Machao615/Dummy-Mar/5.Misc/PCB/controller_bot.jpg

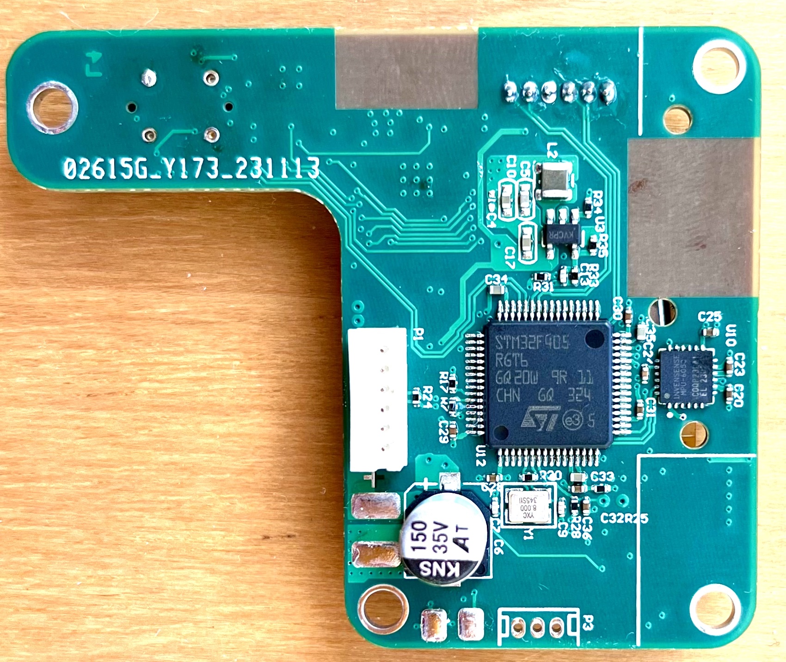
5.Misc/PCB/controller_bot.jpg
