Machao615/Dummy-Mar/5.Misc/PCB/top.jpg

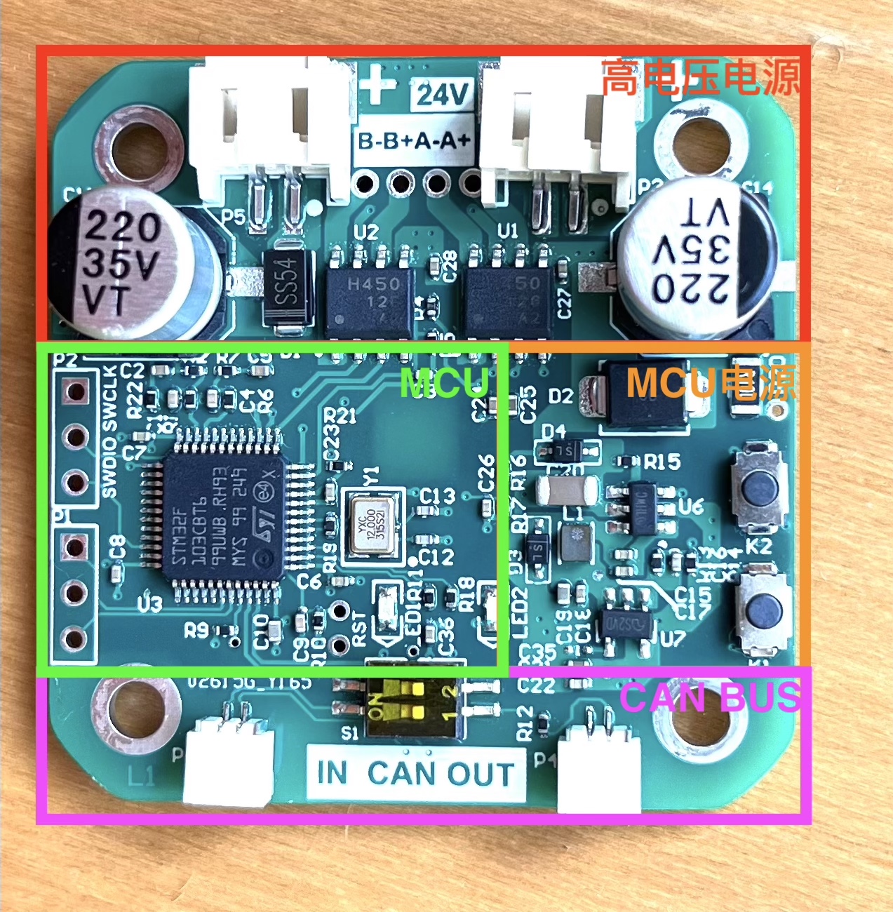
5.Misc/PCB/top.jpg
