Machao615/Dummy-Mar/3.Firmware/esp32-iot/firmware/examples/device-dashboard/screenshots/dashboard.webp

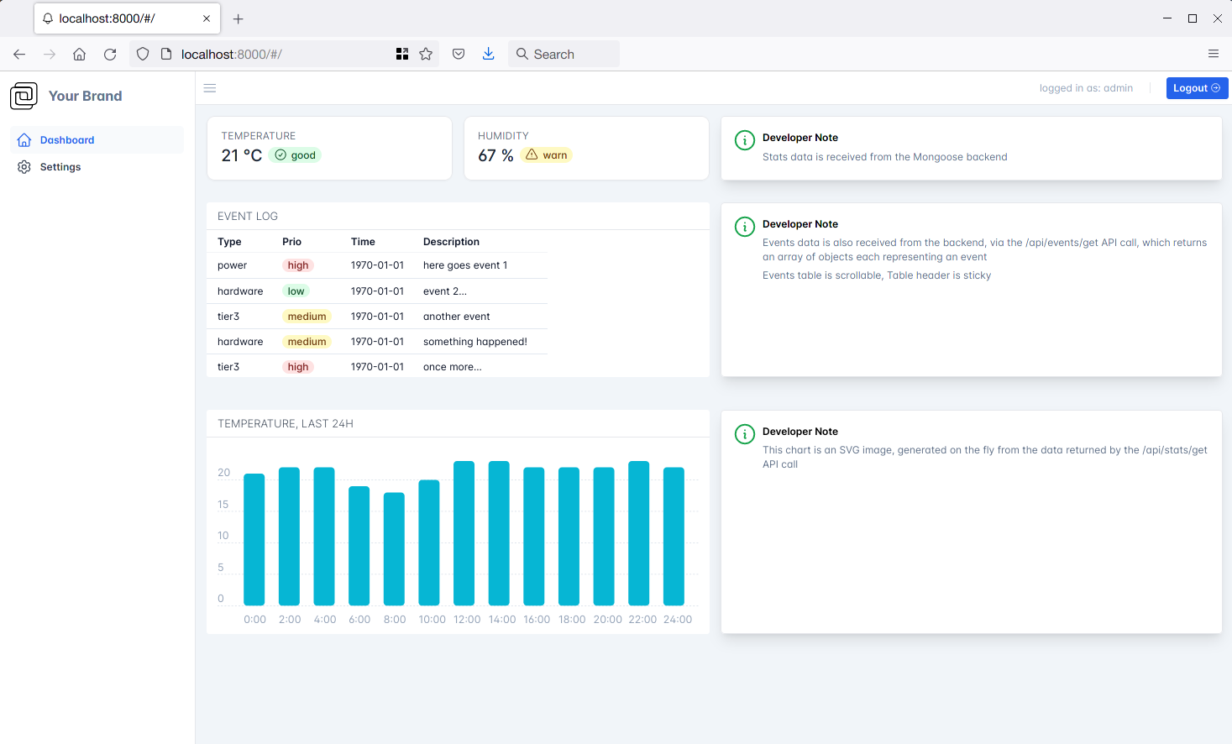
3.Firmware/esp32-iot/firmware/examples/device-dashboard/screenshots/dashboard.webp
