Machao615/Dummy-Mar/3.Firmware/esp32-iot/firmware/examples/uart-bridge/screenshots/dashboard.png

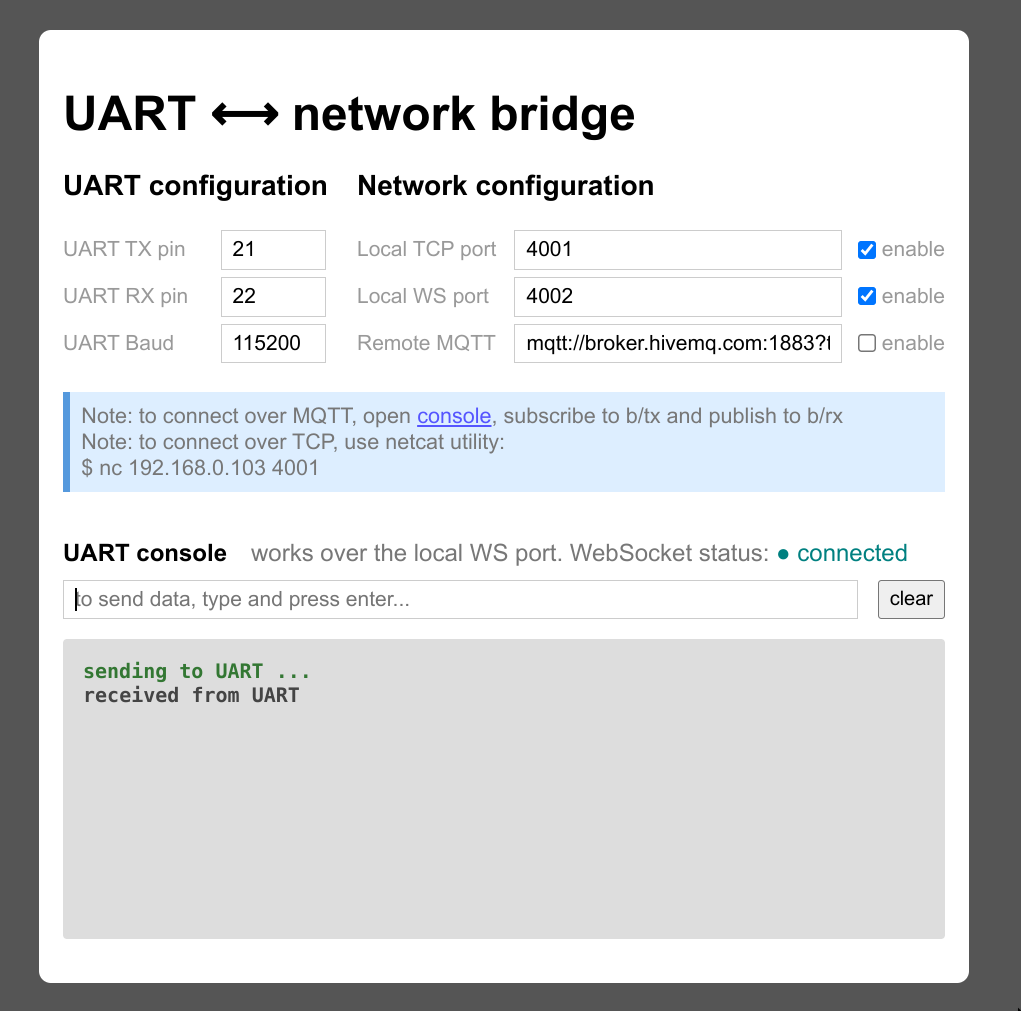
3.Firmware/esp32-iot/firmware/examples/uart-bridge/screenshots/dashboard.png
