Machao615/Dummy-Mar/3.Firmware/esp32-iot/firmware/examples/video-stream/images/1.jpg

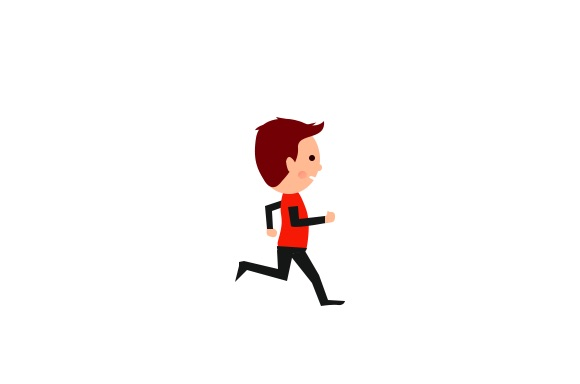
3.Firmware/esp32-iot/firmware/examples/video-stream/images/1.jpg
