Machao615/Dummy-Mar/3.Firmware/esp32-iot/firmware/examples/webui-login/web_root/user.png

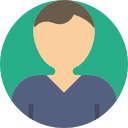
3.Firmware/esp32-iot/firmware/examples/webui-login/web_root/user.png
