Machao615/Dummy-Mar/4.Software/DummyRobot-SDK/reference_assets/giulioz_input.gif

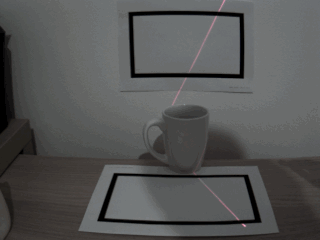
4.Software/DummyRobot-SDK/reference_assets/giulioz_input.gif
