Machao615/Dummy-Mar/5.Misc/02dd3e9cb70d260ed7a63c2eaafac5c.jpg

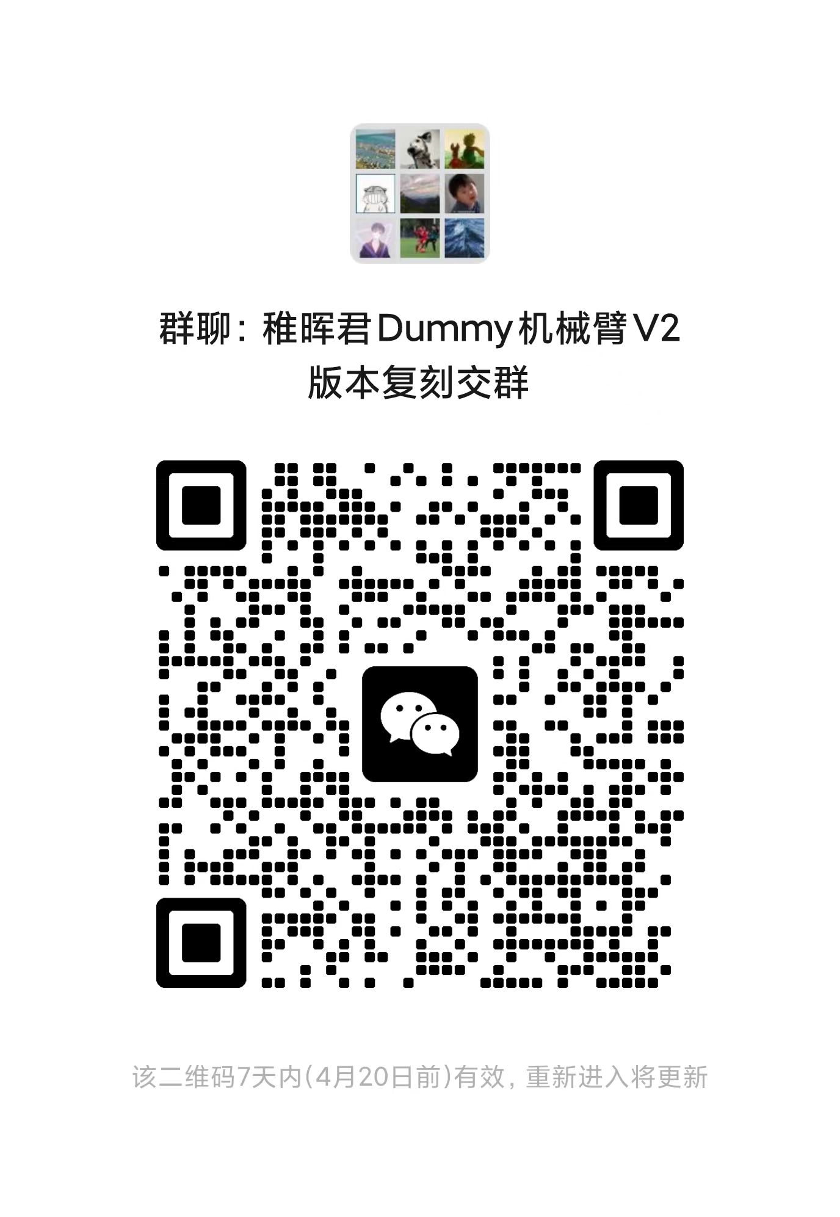
5.Misc/02dd3e9cb70d260ed7a63c2eaafac5c.jpg
