Machao615/Dummy-Mar/5.Misc/DH参数/dummy V2 版本 DH参数.png

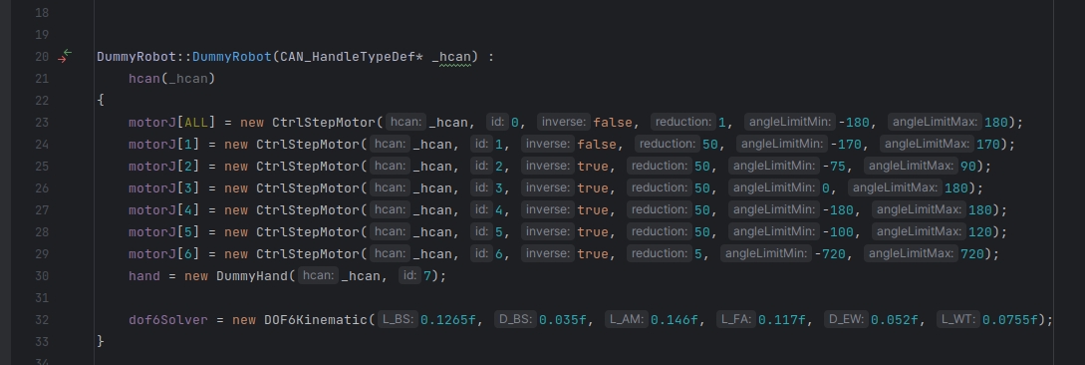
5.Misc/DH参数/dummy V2 版本 DH参数.png
