Machao615/Dummy-Mar/5.Misc/DH参数/fw2.jpg

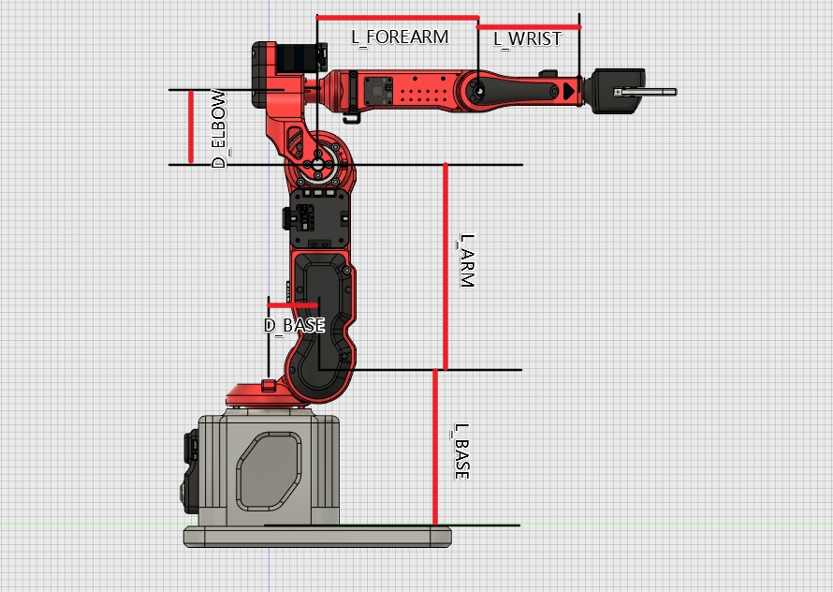
5.Misc/DH参数/fw2.jpg
