Machao615/Dummy-Mar/5.Misc/PCB/controller_top.jpg

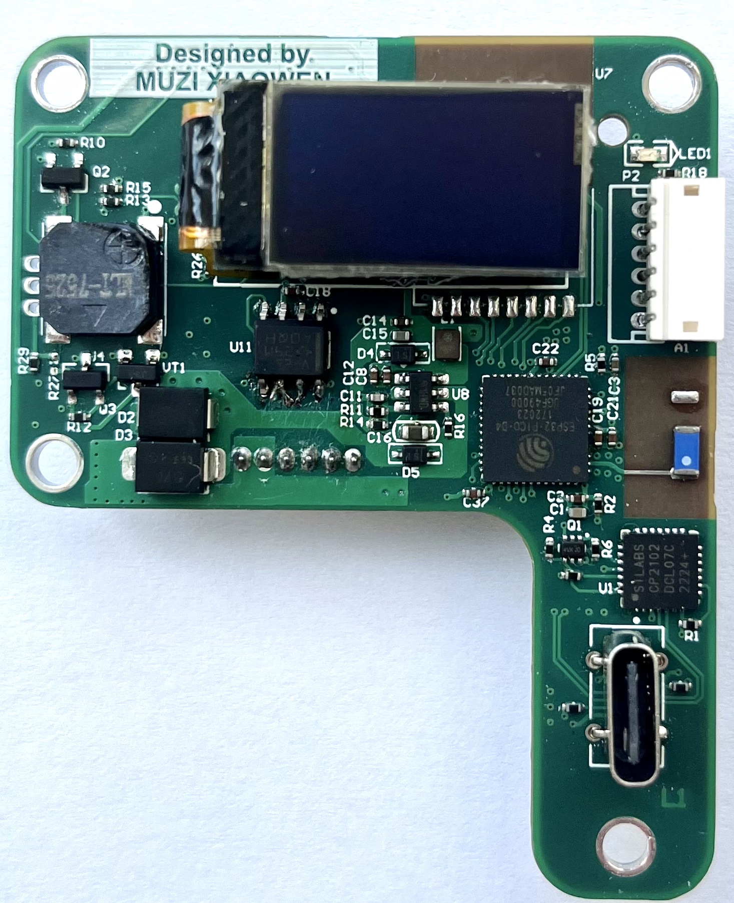
5.Misc/PCB/controller_top.jpg
