Machao615/Dummy-Mar/5.Misc/PCB/m35.jpg

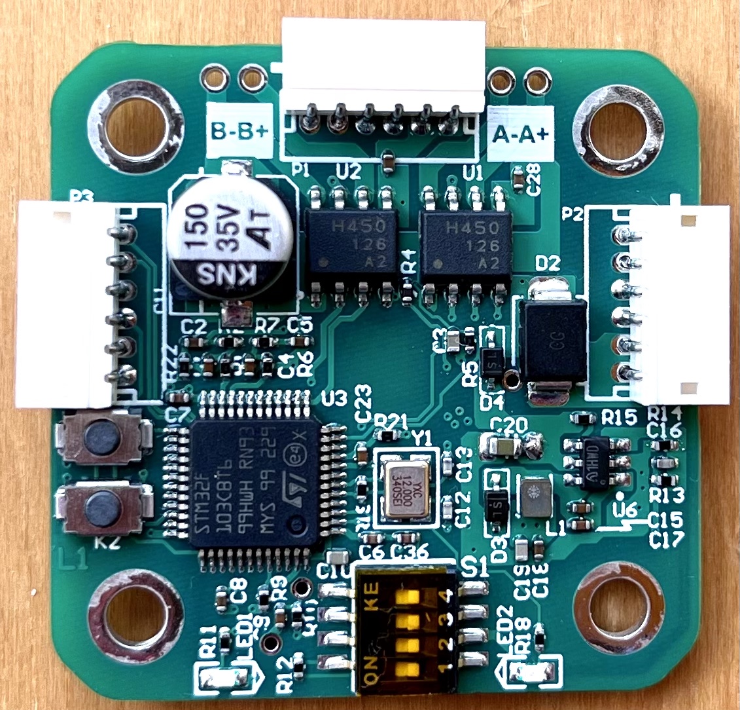
5.Misc/PCB/m35.jpg
