Machao615/Dummy-Mar/5.Misc/其他/fw2.png

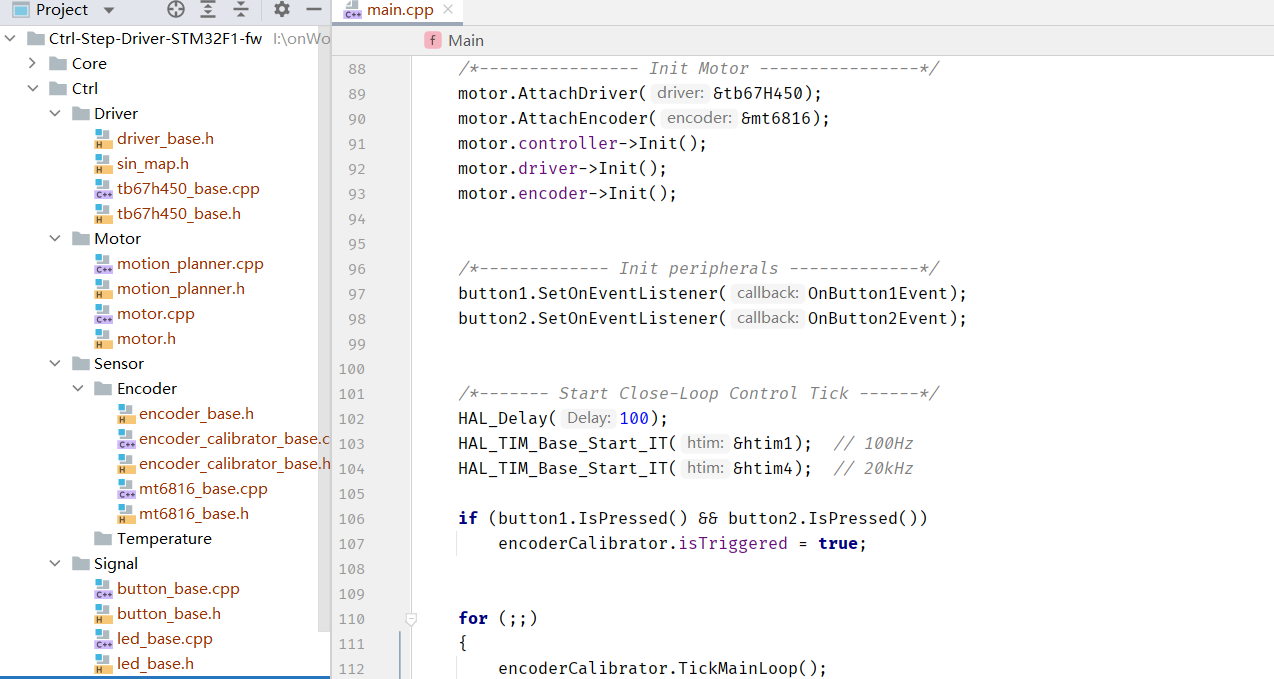
5.Misc/其他/fw2.png
