Machao615/Dummy-Mar/5.Misc/减速器参数/mini8_parameters.JPG

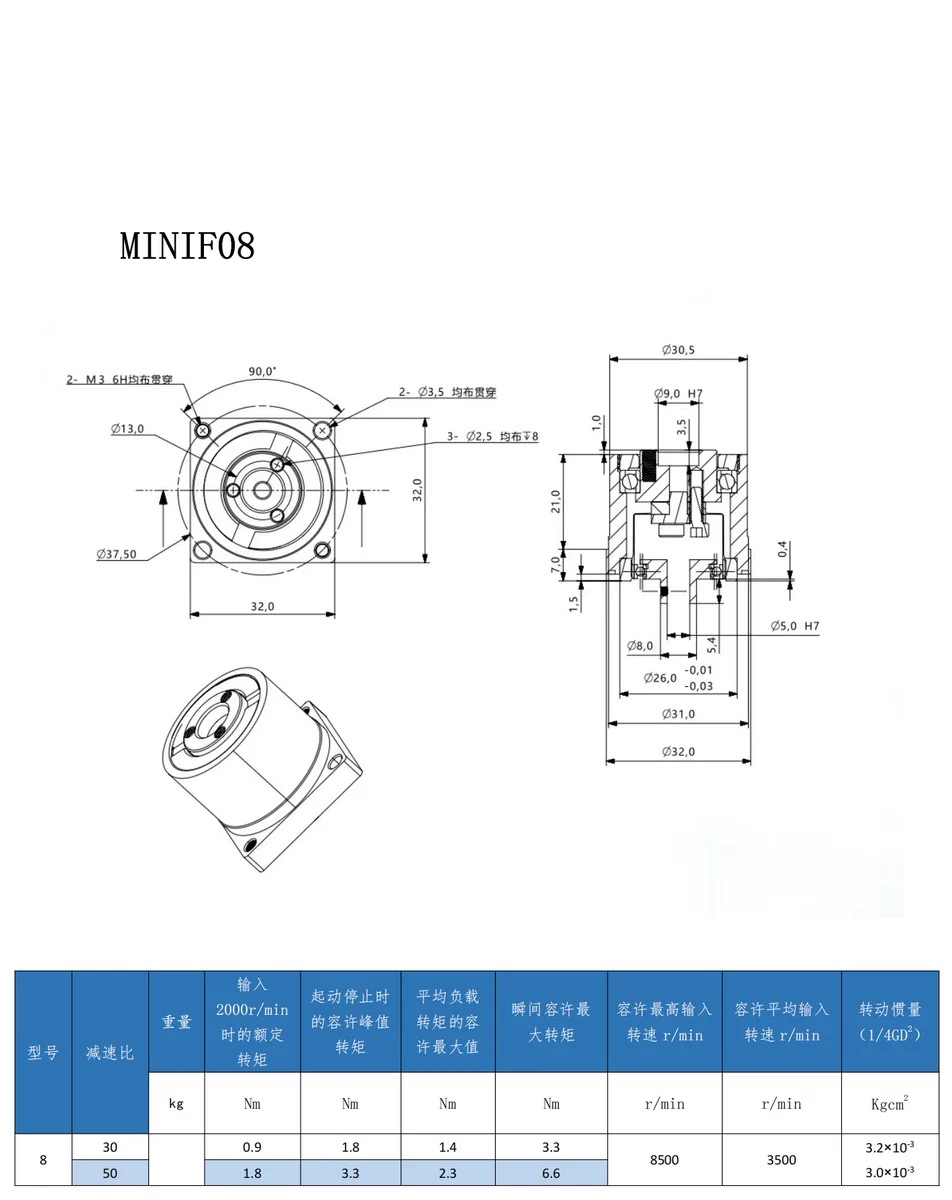
5.Misc/减速器参数/mini8_parameters.JPG
