Machao615/Dummy-Mar/5.Misc/微信截图_20240420204129.png

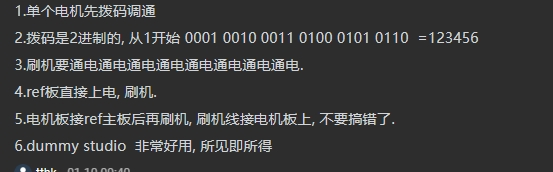
5.Misc/微信截图_20240420204129.png
