Machao615/Dummy-Mar/5.Misc/电机PID/PID.png

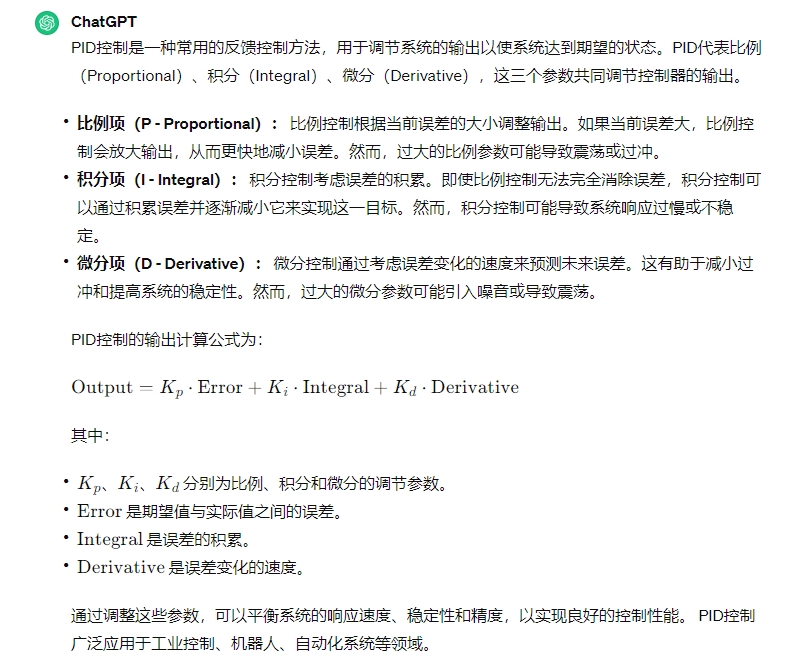
5.Misc/电机PID/PID.png
