Machao615/Dummy-Mar/5.Misc/配色/橙色.jpg

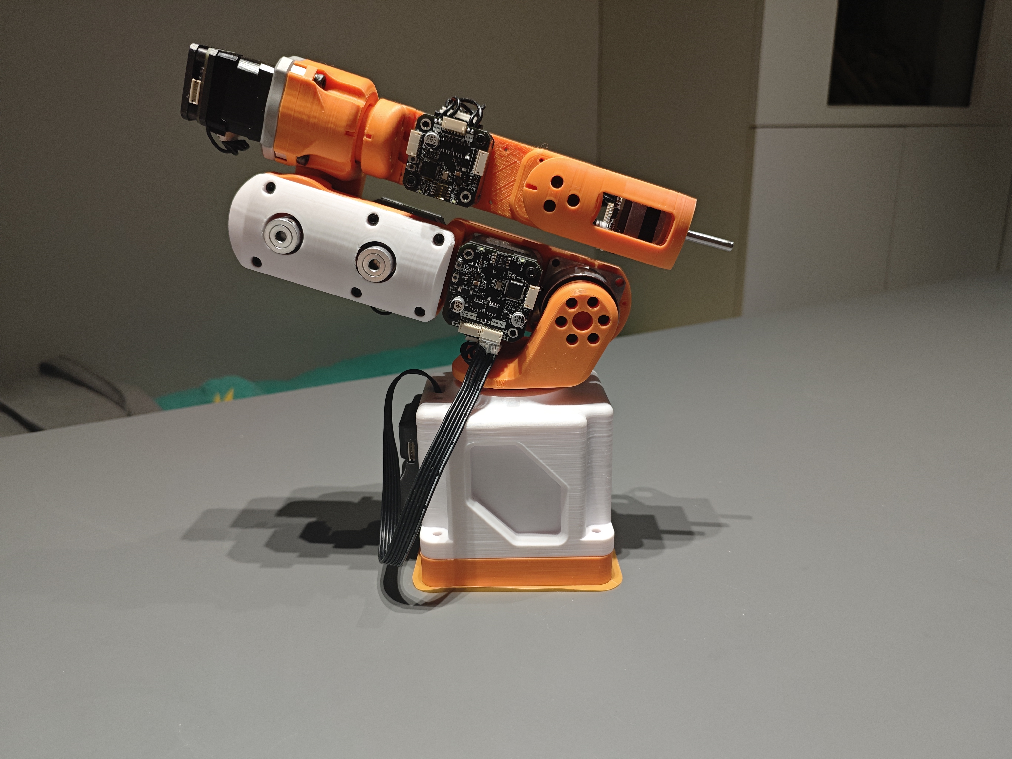
5.Misc/配色/橙色.jpg
