Machao615/Dummy-Mar/5.Misc/配色/红色.jpg

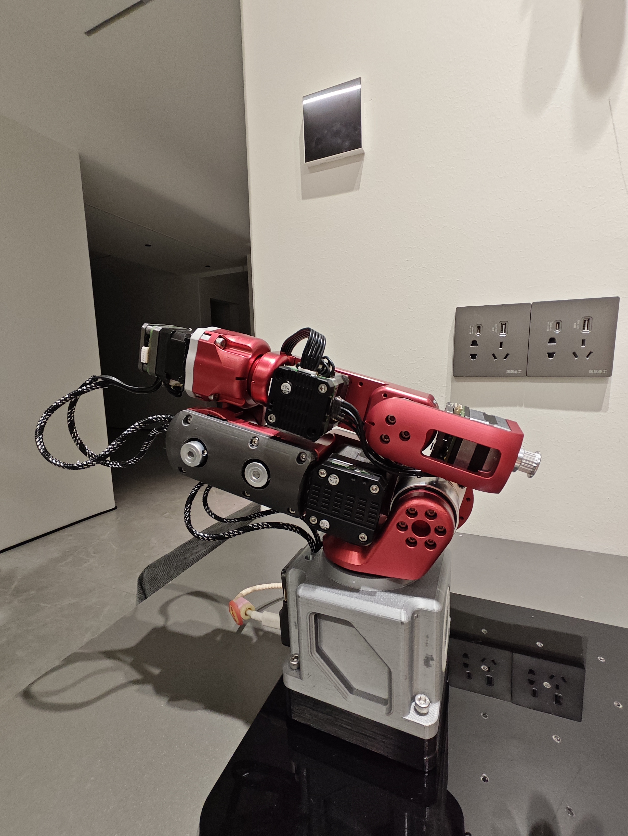
5.Misc/配色/红色.jpg
