Machao615/Dummy-Mar/5.Misc/dummy V2版本_bom.xlsx

Sheet: REF
Comment | Quantity | Designator | Footprint | Layer | 淘宝价格 | 立创价格 | 备注
0R | 4 | R2, R26, R27, R29 | RES_0402_1 | Top
0.1uF | 9 | C2, C8, C12, C14, C18, C19, C21, C22, C37 | CAP_0402 | Top
1K | 1 | R13 | RES_0402_1 | Top
1M | 1 | R16 | RES_0402_1 | Top
1uF | 1 | C3 | CAP_0402 | Top
1.8K | 1 | R14 | RES_0402_1 | Top
2K | 2 | R12, R18 | RES_0402_1 | Top
4.7K | 3 | R19, R20, R23 | RES_0402_1 | Top
4.7uF | 1 | C16 | C0603 | Top
5.1K | 2 | R8, R9 | RES_0402_1 | Top
6.8uH | 1 | L1 | IND-201612 | Top
10K | 6 | R1, R5, R10, R11, R15, R21 | RES_0402_1 | Top
10uF | 4 | C1, C15, C26, C27 | CAP_0402 | Top
12K | 2 | R4, R6 | RES_0402_1 | Top
100pF | 1 | C11 | CAP_0402 | Top
200R | 1 | R3 | RES_0402_1 | Top
560K | 1 | R22 | RES_0402_1 | Top
AO3400A | 1 | Q2 | SOT23-3 | Top
AO3401A | 1 | Q3 | SOT23-3 | Top
BC847BVC-7 | 1 | Q1 | SOT563-6 | Top
CP2102 | 1 | U1 | QFN-28 | Top | 7.50 | 12.80
ESP32_SIP | 1 | U2 | QFN-48_7X7 | Top | 7.80 | 23
Header 6H | 1 | P2 | CONN-TH_HC-ZH1.5-6A-s | Top
LED GREEN | 1 | LED1 | LED-0603 | Top
ME3116 | 1 | U8 | SOT23-6 | Top
MLT-7525 | 1 | U4 | BUZ-SMD_4P-L7.5-W7.5-P7.59-TL | Top
NRF24L01 | 1 | U7 | NRF24L01-MODULE | Top | 5.80
OLED-12880 | 1 | 1 | OLED-12880 | Top
RAINSUN | 1 | A1 | ANT-Rainsun-AN5120 | Top | 1
S8050 | 1 | VT1 | SMT_TRIODE_NPN | Top
SMBJ28CA | 1 | D3 | SMBJ-CA_MFG | Top
SN65HVD232D | 1 | U11 | SO-8 | Top | 3 | 6
SS54 | 1 | D2 | DO-214AC | Top
USB-TYPE-C-STAND | 1 | J1 | USB-TYPE-C-STAND | Top
b5819W | 2 | D4, D5 | SOD-323 | Top
0R | 2 | R25, R31 | RES_0402_1 | Bottom
0.1uF | 10 | C4, C20, C23, C25, C28, C29, C30, C31, C32, C36 | CAP_0402 | Bottom
1M | 1 | R30 | RES_0402 | Bottom
2K | 2 | R7, R17 | RES_0402_1 | Bottom
2.2nF | 1 | C24 | CAP_0402 | Bottom
2.2uH | 1 | L2 | IND-252012A-2R2 | Bottom
10K | 2 | R28, R34 | RES_0402_1 | Bottom
10uF | 3 | C33, C34, C35 | CAP_0402 | Bottom
20pF | 2 | C7, C9 | CAP_0402 | Bottom
20pF | 1 | C13 | CAP_0402 | Bottom
22uF | 3 | C5, C10, C17 | C0603 | Bottom
22.1K | 1 | R35 | RES_0402_1 | Bottom
100K | 1 | R33 | RES_0402_1 | Bottom
120R/NC | 1 | R24 | RES_0402_1 | Bottom
220uF/25V | 1 | C6 | CAP-SMD_BD8.0-L8.3-W8.3-LS9.3-FD | Bottom
Header 3 | 1 | P3 | CONN-TH_HC-ZH1.5-3A-S | Bottom
Header 6H | 1 | P1 | CONN-TH_HC-ZH1.5-6A | Bottom
MPU6050 | 1 | U10 | QFN-24 | Bottom | 4.70
STM32F405RGT6 | 1 | U12 | LQFP-64_N | Bottom | 19.80 | 29.60
SY8089 2A | 1 | U3 | SOT23-5 | Bottom
XTAL-4 | 1 | Y1 | LC-SMD-3225_4P | Bottom
红色为淘宝购买合计：162元 |  |  |  | 元器件合计285元 电路板制作费用110元
绿色为商城购买合计：&#10;123元
淘宝链接如下，不保证好坏哈，我测试过大部分没有问题
NRF24L01+无线收发模块 2.4G数传发射接收通信模块迷你功率加强版-tmall.com天猫
原装正品 MPU6050 芯片 陀螺仪/加速度计 6轴 可编程 I2C QFN-24-tmall.com天猫
原装MT6816CT-ACD 6816 SOP-8 零延迟磁角线性位置传感器现货直发-淘宝网 (taobao.com)
LP2992AIM5X/2981AIM5-3.3/NOPB低压差线性稳压LDO贴片SOT23-5-淘宝网 (taobao.com)
全新原装 TB67H450FNG TB67H451FNGTB67H450 67H451 贴片SOP8-淘宝网 (taobao.com)
原装正品 贴片 CP2102-GMR QFN-28 USB转UART 桥接控制器芯片-淘宝网 (taobao.com)
原装正品 ESP32-D0WD-V3 QFN-48 双核Wi-Fi&蓝牙MCU无线收发芯片-淘宝网 (taobao.com)
原装正品 AN2051-245 2.4G全向天线 RF射频蓝牙 陶瓷贴片WIFI内置-淘宝网 (taobao.com)
SN65HVD232DR 232D VP233 234 235 251 252 255 256 收发器 SOP-8-tmall.com天猫
STM32F103C8T6/CBT6/RBT6/VBT6/RET6/RDT6/ZET6/VET6/VCT6/RCT6原-淘宝网 (taobao.com)
STM32F405RGT6 LQFP-64 全新原装正品 优势低价 渠道直售现货-淘宝网 (taobao.com)
屏幕优信0.78寸OLED裸屏显示液晶屏 分&#10;辨率128*80 SPI接口 SH1107驱动https://item.taobao.com/item.htm?_u=d23g2a9g7f8b&id=665034068875&spm=a1z09.2.0.0.567c2e8dsQorFS

Sheet: Motor-42
Comment | Description | Designator | Footprint | Quantity | Layer | 淘宝价格 | LC价格 | 备注
0.1R | Resistor | R3, R8 | 1206-RES | 2 | Bottom
10uF/50V | Capacitor, chip, ceramic | C29, C30, C31, C32, C33, C34 | 1206-CAP | 6 | Bottom
MT6816 | Magnetic Position Sensor | U8 | SO-8 | 1 | Bottom | 9 | 18.39
SN65HVD232D |  | U5 | so-8 | 1 | Bottom | 3 | 6
0 | Resistor | R21, R22 | RES_0402 | 2 | Top
0R | Resistor | R20 | 1206-RES | 1 | Top
0.1uF | Capacitor | C1, C2, C4, C5, C6, C7, C8, C9, C15, C17, C18, C21, C23, C25, C26, C27, C28, C35, C36 | CAP_0402 | 19 | Top
1K | Resistor | R1, R2, R6, R7, R11, R17, R18 | RES_0402 | 7 | Top
1M | Resistor | R15, R19 | RES_0402 | 2 | Top
1.8K | Resistor | R14 | RES_0402 | 1 | Top
3.3K | Resistor | R5 | RES_0402 | 1 | Top
6.8uH |  | L1 | IND-201612 | 1 | Top
10K | Resistor | R9, R10, R13, R16 | RES_0402 | 4 | Top
10uF | Capacitor | C3, C10, C19, C22, C24 | CAP_0402 | 5 | Top
10uF/50V | Capacitor | C20 | 1206-CAP | 1 | Top
20pF | Capacitor | C12, C13 | CAP_0402 | 2 | Top
100pF | Capacitor | C16 | CAP_0402 | 1 | Top
120R | Resistor | R12 | RES_0402 | 1 | Top
220uF/25V | Capacitor, chip, ceramic | C11, C14 | CAP-SMD_BD8.0-L8.3-W8.3-LS9.3-FD | 2 | Top
DSHP04TSGER | DIP Switches / SIP Switches 4 pos. low profile Btm Seal Tape J Bend | S1 | SW-SMD_DSHP04TS-S | 1 | Top
Header 6H | Header, 6-Pin, Right Angle | P1, P2, P3 | CONN-TH_HC-ZH1.5-6A-s | 3 | Top
LED GREEN | LED GRN SGL RA 25mA 4.1V SMD | LED1, LED2 | LED-0603 | 2 | Top
LP2992 3V3 | LDO | U7 | SOT23-5 | 1 | Top
ME3116 | DC-DC | U6 | SOT23-6 | 1 | Top
NCP15XH103F03RC | THERMISTOR 10K OHM NTC 0402 SMD | R4 | RES_0402 | 1 | Top
SMBJ28CA |  | D2 | SMBJ-CA_MFG | 1 | Top
SS54 | Diode | D1 | DO-214AC | 1 | Top
STM32F103CBT6 | ARM Cortex-M3 32-bit MCU, 128 KB Flash, 20 KB Internal RAM, 37 I/Os, 48-pin LQFP, -40 to 85 degC, Tray | U3 | LQFP-48 | 1 | Top | 16.80 | 29
TACT 2P | Button | K1, K2 | ButtonTACT_3x4x2_180 | 2 | Top |  |  | TS1185
TB67H450FNG | PWM Chopper Type DC Brushed Motor Driver | U1, U2 | SO-8-PAD | 2 | Top | 1.48 | 3.25
XTAL-4 | Crystal | Y1 | LC-SMD-3225_4P | 1 | Top
二极管-5819W | 40V | D3, D4 | SOD-323 | 2 | Top

Sheet: Motor-35
Comment | Quantity | Description | Designator | Footprint | Layer | 淘宝价格 | LC价格 | 备注
0R | 1 | Resistor | R20 | 1206-RES | Bottom
0.1R | 2 | Resistor | R3, R8 | 1206-RES | Bottom
0.1uF | 2 | Capacitor | C21, C25 | CAP_0402 | Bottom
10uF | 2 | Capacitor | C22, C24 | CAP_0402 | Bottom
10uF/50V | 4 | Capacitor, chip, ceramic | C29, C30, C31, C32 | 1206-CAP | Bottom
LP2992 3V3 | 1 | LDO | U7 | SOT23-5 | Bottom
MT6816 | 1 | Magnetic Position Sensor | U8 | SO-8 | Bottom
SN65HVD232D | 1 |  | U5 | so-8 | Bottom
SS54 | 1 | Diode | D1 | DO-214AC | Bottom
0 | 2 | Resistor | R21, R22 | RES_0402 | Top
0.1uF | 15 | Capacitor | C1, C2, C4, C5, C6, C7, C8, C9, C15, C17, C18, C23, C27, C28, C36 | CAP_0402 | Top
1K | 6 | Resistor | R1, R2, R6, R7, R11, R18 | RES_0402 | Top
1M | 2 | Resistor | R15, R19 | RES_0402 | Top
1.8K | 1 | Resistor | R14 | RES_0402 | Top
3.3K | 1 | Resistor | R5 | RES_0402 | Top
6.8uH | 1 |  | L1 | IND-201612 | Top
10K | 3 | Resistor | R9, R10, R13 | RES_0402 | Top
10uF | 3 | Capacitor | C3, C10, C19 | CAP_0402 | Top
10uF/50V | 1 | Capacitor | C20 | 1206-CAP | Top
20pF | 2 | Capacitor | C12, C13 | CAP_0402 | Top
100pF | 1 | Capacitor | C16 | CAP_0402 | Top
120R | 1 | Resistor | R12 | RES_0402 | Top
220uF/25V | 1 | Capacitor, chip, ceramic | C11 | CAP-SMD_BD8.0-L8.3-W8.3-LS9.3-FD | Top
DSHP04TSGER | 1 | DIP Switches / SIP Switches 4 pos. low profile Btm Seal Tape J Bend | S1 | SW-SMD_DSHP04TS-S | Top
Header 6H | 3 | Header, 6-Pin, Right Angle | P1, P2, P3 | CONN-TH_HC-ZH1.5-6A-s | Top
LED GREEN | 2 | LED GRN SGL RA 25mA 4.1V SMD | LED1, LED2 | LED-0603 | Top
ME3116 | 1 | DC-DC | U6 | SOT23-6 | Top
NCP15XH103F03RC | 1 | THERMISTOR 10K OHM NTC 0402 SMD | R4 | RES_0402 | Top
SMBJ28CA | 1 |  | D2 | SMBJ-CA_MFG | Top
STM32F103CBT6 | 1 | ARM Cortex-M3 32-bit MCU, 128 KB Flash, 20 KB Internal RAM, 37 I/Os, 48-pin LQFP, -40 to 85 degC, Tray | U3 | LQFP-48 | Top | 4.48 | 10.56
TACT 2P | 2 | Button | K1, K2 | ButtonTACT_3x4x2_180 | Top |  |  | TS1185
TB67H450FNG | 2 | PWM Chopper Type DC Brushed Motor Driver | U1, U2 | SO-8-PAD | Top | 1.48 | 3.25
XTAL-4 | 1 | Crystal | Y1 | LC-SMD-3225_4P | Top
二极管-5819W | 2 | 40V | D3, D4 | SOD-323 | Top

Sheet: 部分淘宝购买版123元
购买类型 | 商品编号 | 物料编码 | 商品分类 | 名称 | 商品型号 | 品牌 | 封装规格 | 单个毛重 | 购买数量 | 商品单价 | 金额
常规 | C95299 |  | 蜂鸣器 | MLT-7525 编带 | MLT-7525 | 华能 | SMD,7.5x7.5mm | 0.000565000 | 5 | ￥1.3960 | ￥6.98
常规 | C19666 |  | 贴片电容(MLCC) | 4.7uF ±10% 16V 编带 | CL10A475KO8NNNC | SAMSUNG(三星) | 0603 | 0.000040000 | 50 | ￥0.060929 | ￥3.05
常规 | C170075 |  | 贴片电容(MLCC) | 10uF ±20% 50V 编带 | 1206X106M500NT | FH(风华) | 1206 | 0.000048000 | 20 | ￥0.285189 | ￥5.70
常规 | C2682774 |  | 无源晶振 | 8MHz ±10ppm 20pF YSX321SL 编带 | X32258MSB4SI | YXC(扬兴晶振) | SMD3225-4P | 0.000050000 | 5 | ￥0.9797 | ￥4.90
常规 | C4109 |  | 贴片电阻 | 2kΩ ±1% 62.5mW 厚膜电阻 编带 | 0402WGF2001TCE | UNI-ROYAL(厚声) | 0402 | 0.000009000 | 100 | ￥0.003045 | ￥0.30
常规 | C1531 |  | 贴片电容(MLCC) | 2.2nF ±10% 50V 编带 | 0402B222K500NT | FH(风华) | 0402 | 0.000022000 | 100 | ￥0.005762 | ￥0.58
常规 | C77131 |  | NTC热敏电阻 | 10kΩ 电阻精度:±1% 3380K 编带 | NCP15XH103F03RC | muRata(村田) | 0402 | 0.000015000 | 50 | ￥0.077806 | ￥3.89
常规 | C163478 |  | 贴片电阻 | 厚膜电阻 22.1kΩ ±1% 62.5mW 编带 | RC0402FR-0722K1L | YAGEO(国巨) | 0402 | 0.000009000 | 100 | ￥0.003984 | ￥0.40
常规 | C7471880 |  | 贴片型铝电解电容 | 150uF ±20% 35V 编带 | 189RV0018 | KNSCHA(科尼盛) | SMD,D6.3xL7.7mm | 0.000638400 | 10 | ￥0.268320 | ￥2.68
常规 | C97643 |  | DC-DC电源芯片 | ME3116AM6G 编带 | ME3116AM6G | MICRONE(南京微盟) | SOT-23-6 | 0.000055000 | 10 | ￥0.8689 | ￥8.69
常规 | C26083 |  | 贴片电阻 | 1MΩ ±1% 62.5mW 厚膜电阻 编带 | 0402WGF1004TCE | UNI-ROYAL(厚声) | 0402 | 0.000009000 | 100 | ￥0.003249 | ￥0.32
常规 | C726872 |  | 静电和浪涌保护(TVS/ESD) | SMBJ28CA 编带 | SMBJ28CA | TWGMC(台湾迪嘉) | SMB | 0.000152000 | 10 | ￥0.211792 | ￥2.12
常规 | C11702 |  | 贴片电阻 | 1kΩ ±1% 62.5mW 厚膜电阻 编带 | 0402WGF1001TCE | UNI-ROYAL(厚声) | 0402 | 0.000009000 | 100 | ￥0.003136 | ￥0.31
常规 | C561517 |  | 轻触开关 | 4*3*2mm 立贴 轻触开关 编带 | TS-1185-B-A-B-A | XKB Connectivity(中国星坤) | SMD | 0.000140000 | 20 | ￥0.357936 | ￥7.16
常规 | C7371905 |  | 发光二极管/LED | XL-1608PGC-06 编带 | XL-1608PGC-06 | XINGLIGHT(成兴光) | 0603 | 0.000020170 | 50 | ￥0.054250 | ￥2.71
常规 | C25752 |  | 贴片电阻 | 12kΩ ±1% 62.5mW 厚膜电阻 编带 | 0402WGF1202TCE | UNI-ROYAL(厚声) | 0402 | 0.000009000 | 100 | ￥0.003137 | ￥0.31
常规 | C25871 |  | 贴片电阻 | 1.8kΩ ±1% 62.5mW 厚膜电阻 编带 | 0402WGF1801TCE | UNI-ROYAL(厚声) | 0402 | 0.000009000 | 100 | ￥0.003299 | ￥0.33
常规 | C60491 |  | 贴片电阻 | 厚膜电阻 100kΩ ±1% 62.5mW 编带 | RC0402FR-07100KL | YAGEO(国巨) | 0402 | 0.000009000 | 100 | ￥0.003330 | ￥0.33
常规 | C60490 |  | 贴片电阻 | 厚膜电阻 10kΩ ±1% 62.5mW 编带 | RC0402FR-0710KL | YAGEO(国巨) | 0402 | 0.000009000 | 100 | ￥0.003197 | ￥0.32
常规 | C9002 |  | 无源晶振 | 12MHz ±10ppm 20pF YSX321SL 编带 | X322512MSB4SI | YXC(扬兴晶振) | SMD3225-4P | 0.000047000 | 10 | ￥0.372347 | ￥3.72
常规 | C17168 |  | 贴片电阻 | 0Ω ±1% 62.5mW 厚膜电阻 编带 | 0402WGF0000TCE | UNI-ROYAL(厚声) | 0402 | 0.000009000 | 100 | ￥0.003049 | ￥0.30
常规 | C15525 |  | 贴片电容(MLCC) | 10uF ±20% 6.3V 编带 | CL05A106MQ5NUNC | SAMSUNG(三星) | 0402 | 0.000016500 | 100 | ￥0.030332 | ￥3.03
常规 | C1554 |  | 贴片电容(MLCC) | 20pF ±5% 50V 编带 | 0402CG200J500NT | FH(风华) | 0402 | 0.000022000 | 100 | ￥0.006676 | ￥0.67
常规 | C7420331 |  | 肖特基二极管 | 电压:40V 电流:1A 编带 | B5819WS | 宏迦橙 | SOD-323 | 0.000029000 | 50 | ￥0.073235 | ￥3.66
常规 | C25905 |  | 贴片电阻 | 5.1kΩ ±1% 62.5mW 厚膜电阻 编带 | 0402WGF5101TCE | UNI-ROYAL(厚声) | 0402 | 0.000009000 | 100 | ￥0.003127 | ￥0.31
常规 | C25087 |  | 贴片电阻 | 200Ω ±1% 62.5mW 厚膜电阻 编带 | 0402WGF2000TCE | UNI-ROYAL(厚声) | 0402 | 0.000009000 | 100 | ￥0.003063 | ￥0.31
常规 | C22452 |  | 肖特基二极管 | 电压:40V 电流:5A 编带 | SS54 | MDD | SMA(DO-214AC) | 0.000094000 | 10 | ￥0.240837 | ￥2.41
常规 | C25900 |  | 贴片电阻 | 4.7kΩ ±1% 62.5mW 厚膜电阻 编带 | 0402WGF4701TCE | UNI-ROYAL(厚声) | 0402 | 0.000009000 | 100 | ￥0.003081 | ￥0.31
常规 | C7429528 |  | 线对板/线对线连接器 | 1x6P 间距:1.5mm 直插 系列:ZH 袋装 | ZX-ZH1.5-ZZ6P | Megastar(兆星) | 插件,P=1.5mm | 0.000194400 | 10 | ￥0.201855 | ￥2.02
常规 | C501945 |  | 功率电感 | 6.8uH ±20% 870mA 编带 | VLS201612HBX-6R8M-1 | TDK | 0806 | 0.000011000 | 20 | ￥0.350391 | ￥7.01
常规 | C306862 |  | 场效应管(MOSFET) | P沟道 耐压:30V 电流:4.2A 编带 | AO3401A | BORN(伯恩半导体) | SOT-23 | 0.000032000 | 10 | ￥0.249179 | ￥2.49
常规 | C3293144 |  | 拨码开关 | 4位 1.27mm间距贴片型 KE拨码开关 编带 | DSHP04TSGER | 康深 | SMD-8P,5.4x6.6mm | 0.000350000 | 6 | ￥2.77 | ￥16.62
常规 | C14445 |  | 贴片电容(MLCC) | 1uF ±10% 10V 编带 | CL05A105KP5NNNC | SAMSUNG(三星) | 0402 | 0.000016500 | 100 | ￥0.011230 | ￥1.12
常规 | C347475 |  | 场效应管(MOSFET) | N沟道 耐压:30V 电流:5.8A 编带 | AO3400A | UMW(友台半导体) | SOT-23 | 0.000033000 | 20 | ￥0.172511 | ￥3.45
常规 | C7429534 |  | 线对板/线对线连接器 | 1x3P 间距:1.5mm 弯插 系列:ZH 袋装 | ZX-ZH1.5-WZ3P | Megastar(兆星) | 弯插,P=1.5mm | 0.000126900 | 20 | ￥0.111244 | ￥2.22
常规 | C325569 |  | 贴片电阻 | 560kΩ 1% 62.5mW 编带 | RMC0402560K1%N | Tyohm(幸亚电阻) | 0402 | 0.000009000 | 100 | ￥0.013263 | ￥1.33
常规 | C78988 |  | DC-DC电源芯片 | SY8089AAAC 编带 | SY8089AAAC | silergy(矽力杰) | SOT-23-5 | 0.000046000 | 5 | ￥1.2206 | ￥6.10
常规 | C25334 |  | 贴片电阻 | 100mΩ ±1% 250mW 厚膜电阻 编带 | 1206W4F100LT5E | UNI-ROYAL(厚声) | 1206 | 0.000030000 | 100 | ￥0.029143 | ￥2.91
常规 | C1546 |  | 贴片电容(MLCC) | 100pF ±5% 50V 编带 | 0402CG101J500NT | FH(风华) | 0402 | 0.000022000 | 100 | ￥0.005566 | ￥0.56
常规 | C59461 |  | 贴片电容(MLCC) | 22uF ±20% 6.3V 编带 | CL10A226MQ8NRNC | SAMSUNG(三星) | 0603 | 0.000045000 | 50 | ￥0.052209 | ￥2.61
常规 | C2146 |  | 三极管(BJT) | NPN 电流:500mA 耐压:25V H档(200-350) 编带 | S8050 J3Y | CJ(江苏长电/长晶) | SOT-23 | 0.000036000 | 50 | ￥0.089660 | ￥4.48
常规 | C720628 |  | USB连接器 | Type-C 母 立贴 编带 | TYPEC-303-ACP16 | XUNPU(讯普) | SMD | 0.000990000 | 1 | ￥3.11 | ￥3.11
常规 | C60474 |  | 贴片电容(MLCC) | 100nF ±10% 16V 编带 | CC0402KRX7R7BB104 | YAGEO(国巨) | 0402 | 0.000012020 | 100 | ￥0.004896 | ￥0.49
常规 | C25079 |  | 贴片电阻 | 120Ω ±1% 62.5mW 厚膜电阻 编带 | 0402WGF1200TCE | UNI-ROYAL(厚声) | 0402 | 0.000009000 | 100 | ￥0.003163 | ￥0.32
常规 | C25890 |  | 贴片电阻 | 3.3kΩ ±1% 62.5mW 厚膜电阻 编带 | 0402WGF3301TCE | UNI-ROYAL(厚声) | 0402 | 0.000009000 | 100 | ￥0.002998 | ￥0.30
常规 | C150761 |  | 三极管(BJT) | 耐压:45V 电流:100mA 2个NPN 编带 | BC847BVC-7 | DIODES(美台) | SOT-563 | 0.000027000 | 5 | ￥0.410115 | ￥2.05
常规 | C280577 |  | 功率电感 | 2.2uH ±20% 3.3A 编带 | MHCD252012A-2R2M-A8S | chilisin(奇力新) | SMD | 0.000063000 | 10 | ￥0.228092 | ￥2.28
常规 | C7429537 |  | 线对板/线对线连接器 | 1x6P 间距:1.5mm 弯插 系列:ZH 袋装 | ZX-ZH1.5-WZ6P | Megastar(兆星) | 弯插,P=1.5mm | 0.000215000 | 10 | ￥0.214088 | ￥2.14
常规 | C17888 |  | 贴片电阻 | 0Ω ±1% 250mW 厚膜电阻 编带 | 1206W4F0000T5E | UNI-ROYAL(厚声) | 1206 | 0.000030000 | 100 | ￥0.019218 | ￥1.92
订货 | C194087 |  | 贴片型铝电解电容 | 220uF ±20% 25V 管装 | UUN1E221MNQ1ZD | Nichicon(尼吉康) | SMD | 0.002700000 | 2 | ￥2.49 | ￥4.98

Sheet: 一键购买版443元
购买类型 | 商品编号 | 物料编码 | 商品分类 | 名称 | 商品型号 | 品牌 | 封装规格 | 单个毛重 | 购买数量 | 商品单价 | 金额
常规 | C95299 |  | 蜂鸣器 | MLT-7525 编带 | MLT-7525 | 华能 | SMD,7.5x7.5mm | 0.000565000 | 5 | ￥1.3960 | ￥6.98
常规 | C19666 |  | 贴片电容(MLCC) | 4.7uF ±10% 16V 编带 | CL10A475KO8NNNC | SAMSUNG(三星) | 0603 | 0.000040000 | 50 | ￥0.060929 | ￥3.05
常规 | C170075 |  | 贴片电容(MLCC) | 10uF ±20% 50V 编带 | 1206X106M500NT | FH(风华) | 1206 | 0.000048000 | 20 | ￥0.285189 | ￥5.70
常规 | C2682774 |  | 无源晶振 | 8MHz ±10ppm 20pF YSX321SL 编带 | X32258MSB4SI | YXC(扬兴晶振) | SMD3225-4P | 0.000050000 | 5 | ￥0.9797 | ￥4.90
常规 | C4109 |  | 贴片电阻 | 2kΩ ±1% 62.5mW 厚膜电阻 编带 | 0402WGF2001TCE | UNI-ROYAL(厚声) | 0402 | 0.000009000 | 100 | ￥0.003045 | ￥0.30
常规 | C15742 |  | 单片机(MCU/MPU/SOC) | STM32F405RGT6 托盘 | STM32F405RGT6 | ST(意法半导体) | LQFP-64(10x10) | 0.001400000 | 1 | ￥29.60 | ￥29.60
常规 | C30530 |  | CAN芯片 | 1Mbps 3V~3.6V 编带 | SN65HVD232DR | TI(德州仪器) | SOIC-8 | 0.000173000 | 7 | ￥6.07 | ￥42.49
常规 | C1531 |  | 贴片电容(MLCC) | 2.2nF ±10% 50V 编带 | 0402B222K500NT | FH(风华) | 0402 | 0.000022000 | 100 | ￥0.005762 | ￥0.58
常规 | C77131 |  | NTC热敏电阻 | 10kΩ 电阻精度:±1% 3380K 编带 | NCP15XH103F03RC | muRata(村田) | 0402 | 0.000015000 | 50 | ￥0.077806 | ￥3.89
常规 | C163478 |  | 贴片电阻 | 厚膜电阻 22.1kΩ ±1% 62.5mW 编带 | RC0402FR-0722K1L | YAGEO(国巨) | 0402 | 0.000009000 | 100 | ￥0.003984 | ￥0.40
常规 | C7471880 |  | 贴片型铝电解电容 | 150uF ±20% 35V 编带 | 189RV0018 | KNSCHA(科尼盛) | SMD,D6.3xL7.7mm | 0.000638400 | 10 | ￥0.268320 | ￥2.68
常规 | C879560 |  | 位置传感器 | 零延迟磁角位置传感器IC 管装 | MT6816CT-ACD | MagnTek(麦歌恩) | SOP-8 | 0.000150000 | 6 | ￥18.39 | ￥110.34
常规 | C97643 |  | DC-DC电源芯片 | ME3116AM6G 编带 | ME3116AM6G | MICRONE(南京微盟) | SOT-23-6 | 0.000055000 | 10 | ￥0.8689 | ￥8.69
常规 | C26083 |  | 贴片电阻 | 1MΩ ±1% 62.5mW 厚膜电阻 编带 | 0402WGF1004TCE | UNI-ROYAL(厚声) | 0402 | 0.000009000 | 100 | ￥0.003249 | ￥0.32
常规 | C6568 |  | USB芯片 | CP2102-GMR 编带 | CP2102-GMR | SILICON LABS(芯科) | WQFN-28-EP(5x5) | 0.000145000 | 1 | ￥12.84 | ￥12.84
常规 | C726872 |  | 静电和浪涌保护(TVS/ESD) | SMBJ28CA 编带 | SMBJ28CA | TWGMC(台湾迪嘉) | SMB | 0.000152000 | 10 | ￥0.211792 | ￥2.12
常规 | C11702 |  | 贴片电阻 | 1kΩ ±1% 62.5mW 厚膜电阻 编带 | 0402WGF1001TCE | UNI-ROYAL(厚声) | 0402 | 0.000009000 | 100 | ￥0.003136 | ￥0.31
常规 | C561517 |  | 轻触开关 | 4*3*2mm 立贴 轻触开关 编带 | TS-1185-B-A-B-A | XKB Connectivity(中国星坤) | SMD | 0.000140000 | 20 | ￥0.357936 | ￥7.16
常规 | C7371905 |  | 发光二极管/LED | XL-1608PGC-06 编带 | XL-1608PGC-06 | XINGLIGHT(成兴光) | 0603 | 0.000020170 | 50 | ￥0.054250 | ￥2.71
常规 | C25752 |  | 贴片电阻 | 12kΩ ±1% 62.5mW 厚膜电阻 编带 | 0402WGF1202TCE | UNI-ROYAL(厚声) | 0402 | 0.000009000 | 100 | ￥0.003137 | ￥0.31
常规 | C25871 |  | 贴片电阻 | 1.8kΩ ±1% 62.5mW 厚膜电阻 编带 | 0402WGF1801TCE | UNI-ROYAL(厚声) | 0402 | 0.000009000 | 100 | ￥0.003299 | ￥0.33
常规 | C60491 |  | 贴片电阻 | 厚膜电阻 100kΩ ±1% 62.5mW 编带 | RC0402FR-07100KL | YAGEO(国巨) | 0402 | 0.000009000 | 100 | ￥0.003330 | ￥0.33
常规 | C60490 |  | 贴片电阻 | 厚膜电阻 10kΩ ±1% 62.5mW 编带 | RC0402FR-0710KL | YAGEO(国巨) | 0402 | 0.000009000 | 100 | ￥0.003197 | ￥0.32
常规 | C9002 |  | 无源晶振 | 12MHz ±10ppm 20pF YSX321SL 编带 | X322512MSB4SI | YXC(扬兴晶振) | SMD3225-4P | 0.000047000 | 10 | ￥0.372347 | ￥3.72
常规 | C17168 |  | 贴片电阻 | 0Ω ±1% 62.5mW 厚膜电阻 编带 | 0402WGF0000TCE | UNI-ROYAL(厚声) | 0402 | 0.000009000 | 100 | ￥0.003049 | ￥0.30
常规 | C15525 |  | 贴片电容(MLCC) | 10uF ±20% 6.3V 编带 | CL05A106MQ5NUNC | SAMSUNG(三星) | 0402 | 0.000016500 | 100 | ￥0.030332 | ￥3.03
常规 | C1554 |  | 贴片电容(MLCC) | 20pF ±5% 50V 编带 | 0402CG200J500NT | FH(风华) | 0402 | 0.000022000 | 100 | ￥0.006676 | ￥0.67
常规 | C7420331 |  | 肖特基二极管 | 电压:40V 电流:1A 编带 | B5819WS | 宏迦橙 | SOD-323 | 0.000029000 | 50 | ￥0.073235 | ￥3.66
常规 | C25905 |  | 贴片电阻 | 5.1kΩ ±1% 62.5mW 厚膜电阻 编带 | 0402WGF5101TCE | UNI-ROYAL(厚声) | 0402 | 0.000009000 | 100 | ￥0.003127 | ￥0.31
常规 | C25087 |  | 贴片电阻 | 200Ω ±1% 62.5mW 厚膜电阻 编带 | 0402WGF2000TCE | UNI-ROYAL(厚声) | 0402 | 0.000009000 | 100 | ￥0.003063 | ￥0.31
常规 | C22452 |  | 肖特基二极管 | 电压:40V 电流:5A 编带 | SS54 | MDD | SMA(DO-214AC) | 0.000094000 | 10 | ￥0.240837 | ￥2.41
常规 | C25900 |  | 贴片电阻 | 4.7kΩ ±1% 62.5mW 厚膜电阻 编带 | 0402WGF4701TCE | UNI-ROYAL(厚声) | 0402 | 0.000009000 | 100 | ￥0.003081 | ￥0.31
常规 | C7429528 |  | 线对板/线对线连接器 | 1x6P 间距:1.5mm 直插 系列:ZH 袋装 | ZX-ZH1.5-ZZ6P | Megastar(兆星) | 插件,P=1.5mm | 0.000194400 | 10 | ￥0.201855 | ￥2.02
常规 | C501945 |  | 功率电感 | 6.8uH ±20% 870mA 编带 | VLS201612HBX-6R8M-1 | TDK | 0806 | 0.000011000 | 20 | ￥0.350391 | ￥7.01
常规 | C193707 |  | 无线收发芯片 | 集成2.4GHz WIFI和蓝牙的模组 编带 | ESP32-PICO-D4 | ESPRESSIF(乐鑫) | QFN-48-EP(7x7) | 0.000310000 | 1 | ￥23.01 | ￥23.01
常规 | C306862 |  | 场效应管(MOSFET) | P沟道 耐压:30V 电流:4.2A 编带 | AO3401A | BORN(伯恩半导体) | SOT-23 | 0.000032000 | 10 | ￥0.249179 | ￥2.49
常规 | C3293144 |  | 拨码开关 | 4位 1.27mm间距贴片型 KE拨码开关 编带 | DSHP04TSGER | 康深 | SMD-8P,5.4x6.6mm | 0.000350000 | 6 | ￥2.77 | ￥16.62
常规 | C14445 |  | 贴片电容(MLCC) | 1uF ±10% 10V 编带 | CL05A105KP5NNNC | SAMSUNG(三星) | 0402 | 0.000016500 | 100 | ￥0.011230 | ￥1.12
常规 | C545417 |  | 电机驱动芯片 | TB67H450FNG,EL 编带 | TB67H450FNG,EL | TOSHIBA(东芝) | SOIC-8 | 0.000180000 | 6 | ￥3.25 | ￥19.50
常规 | C347475 |  | 场效应管(MOSFET) | N沟道 耐压:30V 电流:5.8A 编带 | AO3400A | UMW(友台半导体) | SOT-23 | 0.000033000 | 20 | ￥0.172511 | ￥3.45
常规 | C7429534 |  | 线对板/线对线连接器 | 1x3P 间距:1.5mm 弯插 系列:ZH 袋装 | ZX-ZH1.5-WZ3P | Megastar(兆星) | 弯插,P=1.5mm | 0.000126900 | 20 | ￥0.111244 | ￥2.22
常规 | C325569 |  | 贴片电阻 | 560kΩ 1% 62.5mW 编带 | RMC0402560K1%N | Tyohm(幸亚电阻) | 0402 | 0.000009000 | 100 | ￥0.013263 | ￥1.33
常规 | C78988 |  | DC-DC电源芯片 | SY8089AAAC 编带 | SY8089AAAC | silergy(矽力杰) | SOT-23-5 | 0.000046000 | 5 | ￥1.2206 | ￥6.10
常规 | C25334 |  | 贴片电阻 | 100mΩ ±1% 250mW 厚膜电阻 编带 | 1206W4F100LT5E | UNI-ROYAL(厚声) | 1206 | 0.000030000 | 100 | ￥0.029143 | ￥2.91
常规 | C1546 |  | 贴片电容(MLCC) | 100pF ±5% 50V 编带 | 0402CG101J500NT | FH(风华) | 0402 | 0.000022000 | 100 | ￥0.005566 | ￥0.56
常规 | C59461 |  | 贴片电容(MLCC) | 22uF ±20% 6.3V 编带 | CL10A226MQ8NRNC | SAMSUNG(三星) | 0603 | 0.000045000 | 50 | ￥0.052209 | ￥2.61
常规 | C2146 |  | 三极管(BJT) | NPN 电流:500mA 耐压:25V H档(200-350) 编带 | S8050 J3Y | CJ(江苏长电/长晶) | SOT-23 | 0.000036000 | 50 | ￥0.089660 | ￥4.48
常规 | C720628 |  | USB连接器 | Type-C 母 立贴 编带 | TYPEC-303-ACP16 | XUNPU(讯普) | SMD | 0.000990000 | 1 | ￥3.11 | ￥3.11
常规 | C60474 |  | 贴片电容(MLCC) | 100nF ±10% 16V 编带 | CC0402KRX7R7BB104 | YAGEO(国巨) | 0402 | 0.000012020 | 100 | ￥0.004896 | ￥0.49
常规 | C25079 |  | 贴片电阻 | 120Ω ±1% 62.5mW 厚膜电阻 编带 | 0402WGF1200TCE | UNI-ROYAL(厚声) | 0402 | 0.000009000 | 100 | ￥0.003163 | ￥0.32
常规 | C25890 |  | 贴片电阻 | 3.3kΩ ±1% 62.5mW 厚膜电阻 编带 | 0402WGF3301TCE | UNI-ROYAL(厚声) | 0402 | 0.000009000 | 100 | ￥0.002998 | ￥0.30
常规 | C150761 |  | 三极管(BJT) | 耐压:45V 电流:100mA 2个NPN 编带 | BC847BVC-7 | DIODES(美台) | SOT-563 | 0.000027000 | 5 | ￥0.410115 | ￥2.05
常规 | C280577 |  | 功率电感 | 2.2uH ±20% 3.3A 编带 | MHCD252012A-2R2M-A8S | chilisin(奇力新) | SMD | 0.000063000 | 10 | ￥0.228092 | ￥2.28
常规 | C7429537 |  | 线对板/线对线连接器 | 1x6P 间距:1.5mm 弯插 系列:ZH 袋装 | ZX-ZH1.5-WZ6P | Megastar(兆星) | 弯插,P=1.5mm | 0.000215000 | 10 | ￥0.214088 | ￥2.14
常规 | C17888 |  | 贴片电阻 | 0Ω ±1% 250mW 厚膜电阻 编带 | 1206W4F0000T5E | UNI-ROYAL(厚声) | 1206 | 0.000030000 | 100 | ￥0.019218 | ￥1.92
订货 | C194087 |  | 贴片型铝电解电容 | 220uF ±20% 25V 管装 | UUN1E221MNQ1ZD | Nichicon(尼吉康) | SMD | 0.002700000 | 2 | ￥2.49 | ￥4.98
订货 | C8304 |  | 单片机(MCU/MPU/SOC) | STM32F103CBT6 托盘 | STM32F103CBT6 | ST(意法半导体) | LQFP-48(7x7) | 0.001100000 | 6 | ￥10.56 | ￥63.36

Sheet: 其它
内容 | 型号 | 数量 | 链接 | 选项2 | 说明
42 电机 | l=40 | 3 | 42步进电机带磁柱孔马达两相四线雕刻机写字机闭环加装3D打印配件-淘宝网 (taobao.com)
35 电机 | l=28 | 2 | 35步进电机带磁柱孔马达两相四线雕刻机写字机闭环加装3D打印配件-淘宝网 (taobao.com)
J6 35电机 | l=20 | 1 | 德川35步进电机套装 雕刻机模大扭矩 电动小马达精密行星减速机器 (taobao.com)
减速器 | mini11 | 4 | https://item.taobao.com/item.htm?_u=d23g2a9g3be8&id=680325492406&spm=a1z09.2.0.0.33632e8dxUv9b1
减速器 | mini8 | 1 | https://item.taobao.com/item.htm?_u=d23g2a9g3be8&id=680325492406&spm=a1z09.2.0.0.33632e8dxUv9b1
同步轮 | 20齿内孔5mm外径18 | 6 | https://item.taobao.com/item.htm?spm=a1z09.2.0.0.19b12e8dfRIPU3&id=625483500699&_u=a3jnrl7adc93
同步皮带 | 已经实测130X2 150X1 | 1 | https://item.taobao.com/item.htm?spm=a1z09.2.0.0.19b12e8dfRIPU3&id=626759355655&_u=a3jnrl7aa476
电源开关 | 开孔直径：16mm，12-24v | 1 | https://item.taobao.com/item.htm?spm=a1z09.2.0.0.6dcd2e8dgKFAl1&id=589544046782&_u=93jnrl7aceb2
DC电源插座 | DC5.5*2.5mm，10cm，插座带线 | 1 | https://item.taobao.com/item.htm?spm=a1z09.2.0.0.6dcd2e8dgKFAl1&id=679108658727&_u=93jnrl7a3b6f
电源 | 24v 6a | 1 | 全新原装雅达机芯24V6A电源适配器 24V5A净水器监控显示器LED直充-淘宝网 (taobao.com) | https://item.taobao.com/item.htm?id=663983891997&ns=1&abbucket=18 | 选项1不发货了，临时选了这个，送母头
6pin排线 | zh1.5mm 50CM(定做) 6P-22AWG | 1 | https://detail.tmall.com/item.htm?_u=93jnrl7a54c7&id=642559605753&spm=a1z09.2.0.0.6dcd2e8dgKFAl1 | https://detail.tmall.com/item.htm?_u=ukdf1tc9c6&id=635056127519&skuId=4710932887411
6pin排线 | zh1.5mm 30CM(定做) 6P-22AWG | 6 | https://detail.tmall.com/item.htm?_u=93jnrl7a54c7&id=642559605753&spm=a1z09.2.0.0.6dcd2e8dgKFAl1 |  | 然后买了上面的自己做端子
圆柱销 | 5X35 | 4 | https://detail.tmall.com/item.htm?_u=723g2a9g8399&id=617042322309&spm=a1z09.2.0.0.3e262e8dTKGxhg
轴承 | 5X13X4 | 4 | 迷你微型轴承小内径1 1.5 2 2.5 3 4 5 6 7 8 9mm高速模型DIY精密-tmall.com天猫
轴承 | 5X10X4 | 1 | https://detail.tmall.com/item.htm?id=611796709407&spm=a1z09.2.0.0.4e6e2e8doarR0H&_u=d23g2a9g3c7e
LED灯 | 505 | 1 | https://item.taobao.com/item.htm?_u=723g2a9g35a9&id=686018450822&spm=a1z09.2.0.0.3e262e8dTKGxhg
螺丝安装下图买即可
