Machao615/Dummy-Mar/2.Model/3D打印STL文件/42PCB外壳B.stl

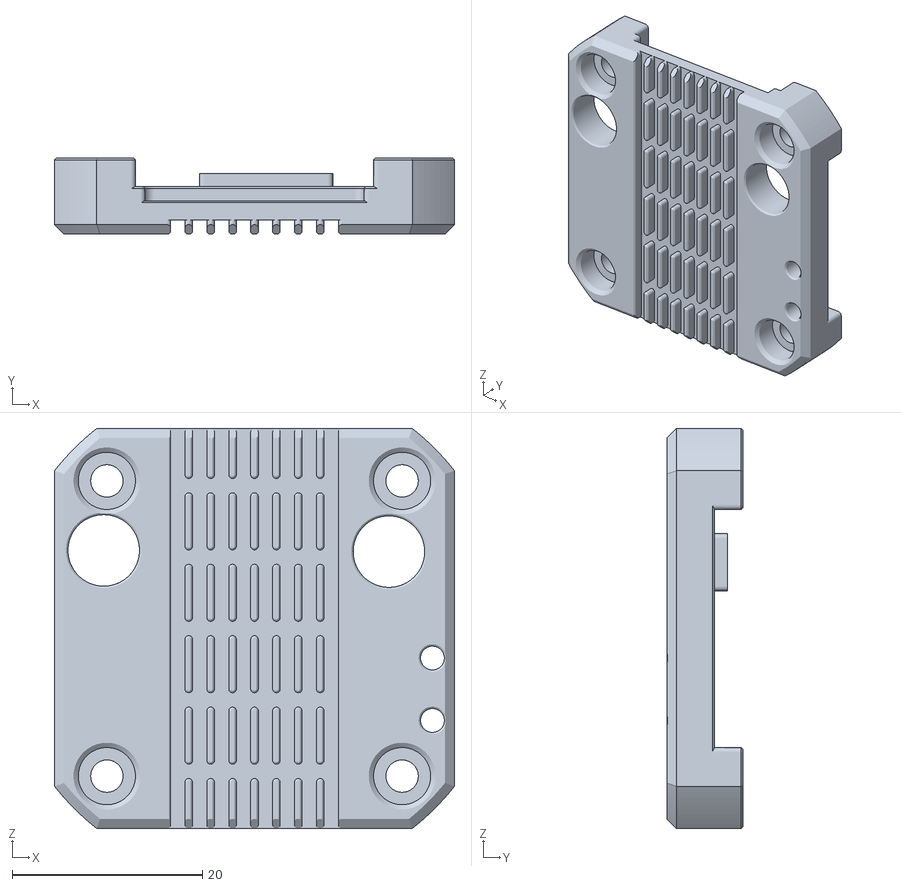
[picture p31: CAD file, 2026-04-15]
2.Model/3D打印STL文件/42PCB外壳B.stl
42.0 x 8.00 x 42.0
