Machao615/Dummy-Mar/2.Model/CNC加工STEP文件/J23.step

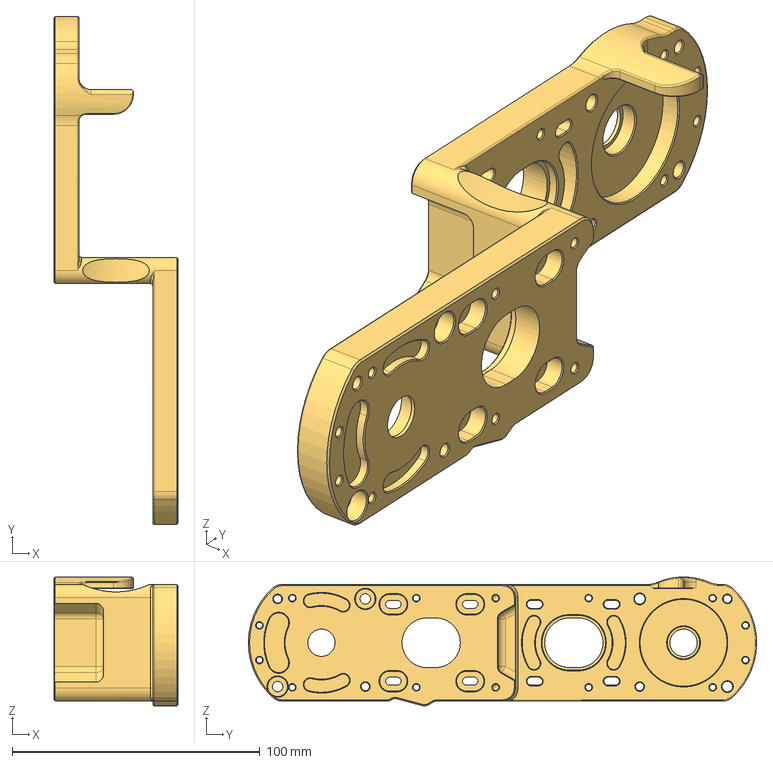
[picture p32: CAD file, 2026-04-15]
2.Model/CNC加工STEP文件/J23.step
50.0 x 205.0 x 52.0 mm
