Machao615/Dummy-Mar/2.Model/改版/基座改版.step

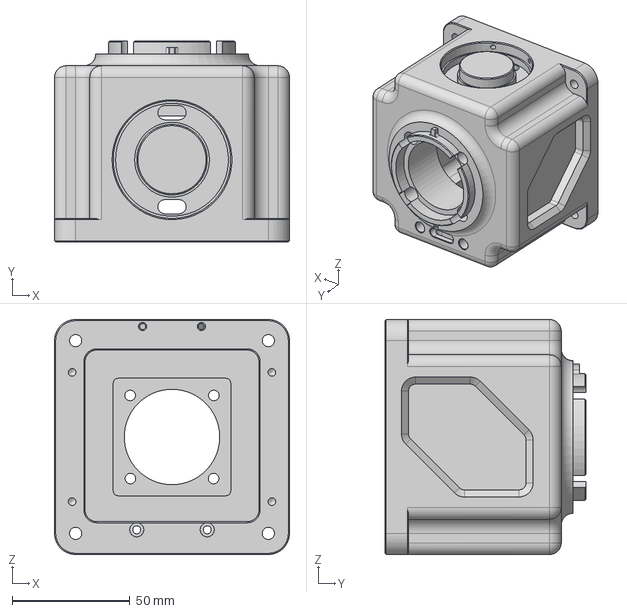
[picture p33: CAD file, 2026-04-15]
2.Model/改版/基座改版.step
100.0 x 85.5 x 100.0 mm
