Machao615/Dummy-Mar/2.Model/3D打印STL文件/J4.stl

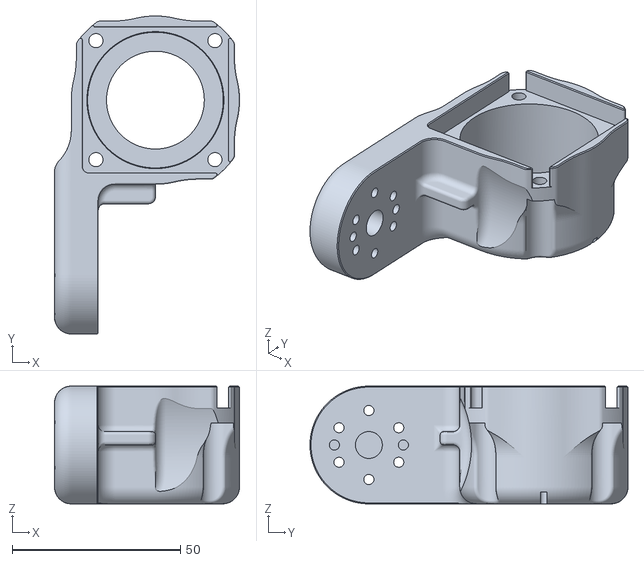
[picture p34: CAD file, 2026-04-15]
2.Model/3D打印STL文件/J4.stl
55.0 x 94.5 x 35.0
