Machao615/Dummy-Mar/2.Model/CNC加工STEP文件/J4法兰盘.step

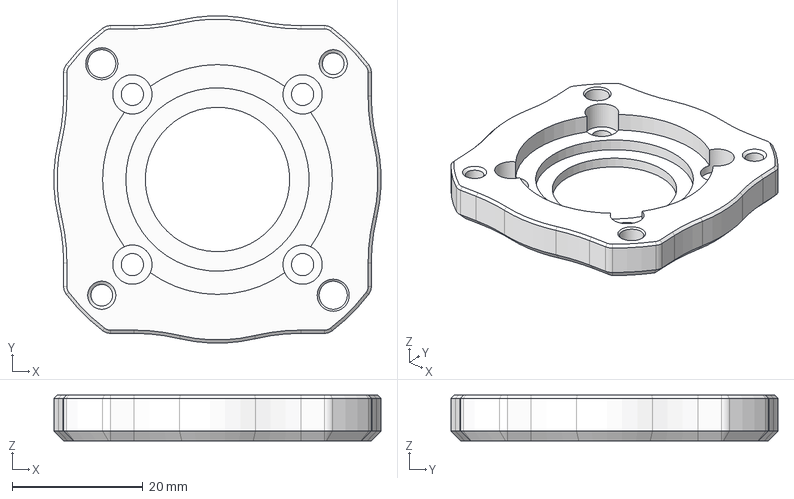
[picture p35: CAD file, 2026-04-15]
2.Model/CNC加工STEP文件/J4法兰盘.step
49.9 x 49.9 x 7.00 mm
