Machao615/Dummy-Mar/2.Model/改版/J1改版.step

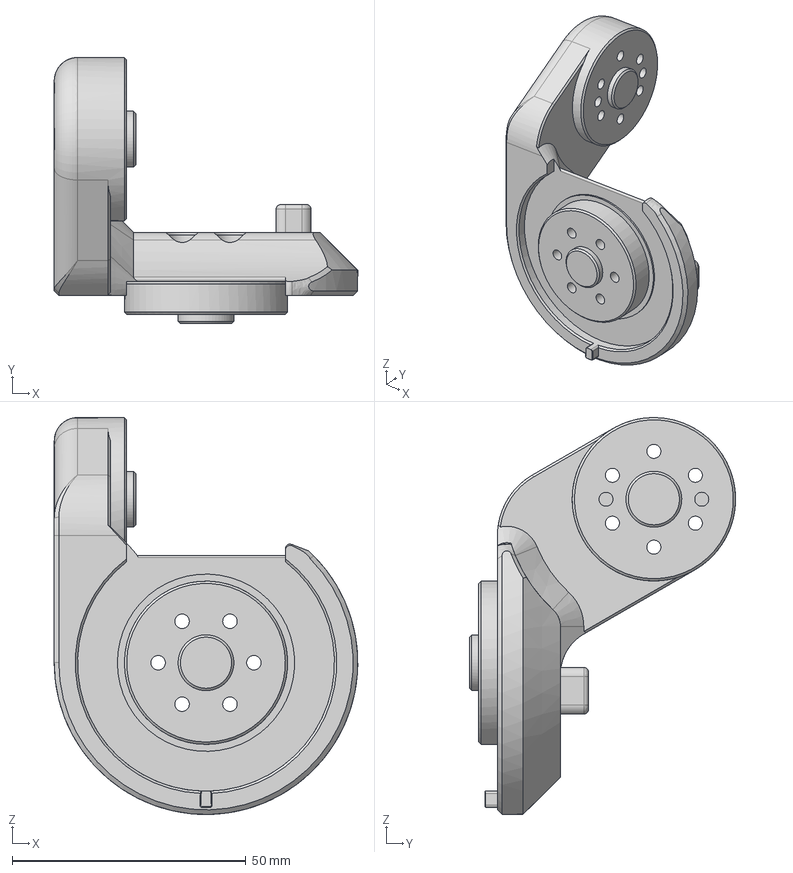
[picture p36: CAD file, 2026-04-15]
2.Model/改版/J1改版.step
65.0 x 57.0 x 85.0 mm
