Machao615/Dummy-Mar/2.Model/3D打印STL文件/基座底板.3mf

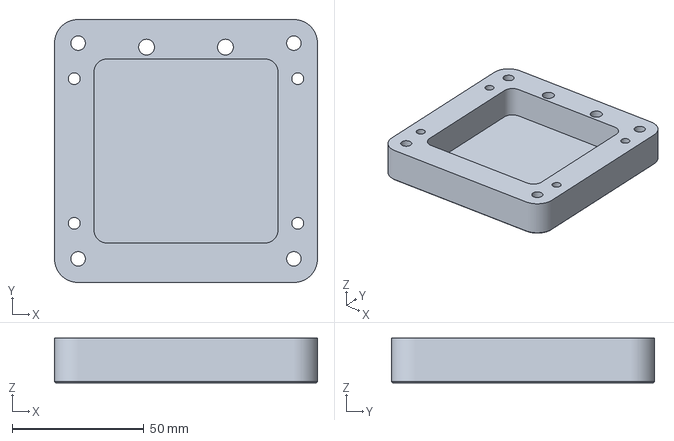
[picture p37: CAD file, 2026-04-15]
2.Model/3D打印STL文件/基座底板.3mf
100.0 x 100.0 x 17.0 mm
