Machao615/Dummy-Mar/2.Model/3D打印STL文件/外壳C.stl

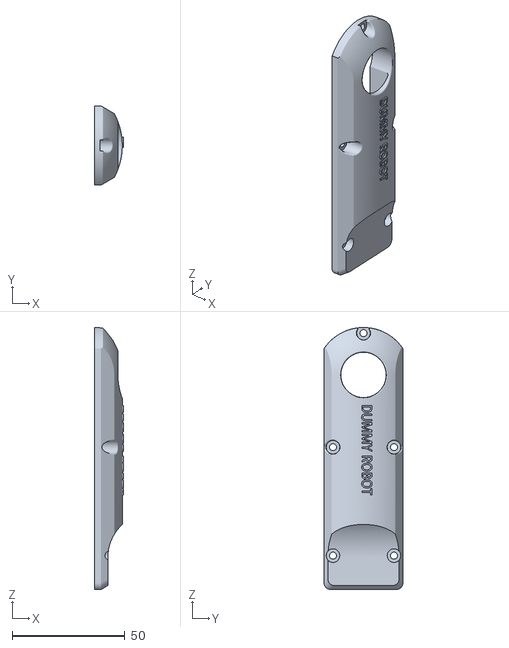
[picture p38: CAD file, 2026-04-15]
2.Model/3D打印STL文件/外壳C.stl
13.0 x 35.0 x 116.0
