Machao615/Dummy-Mar/2.Model/CNC加工STEP文件/J6.step

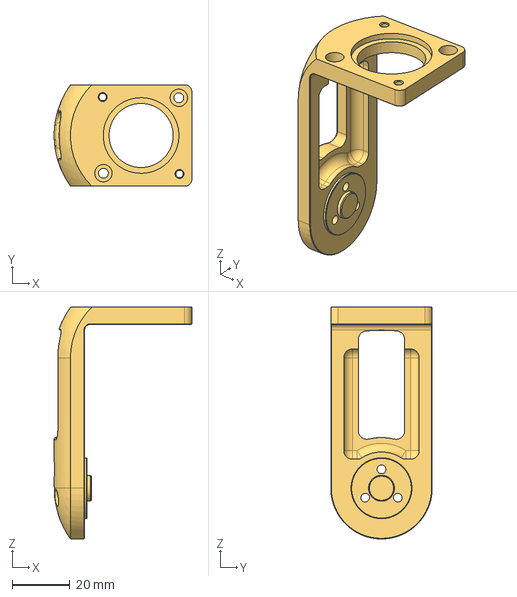
[picture p39: CAD file, 2026-04-15]
2.Model/CNC加工STEP文件/J6.step
47.5 x 35.0 x 80.0 mm
