Machao615/Dummy-Mar/2.Model/3D打印STL文件/42PCB外壳A.stl

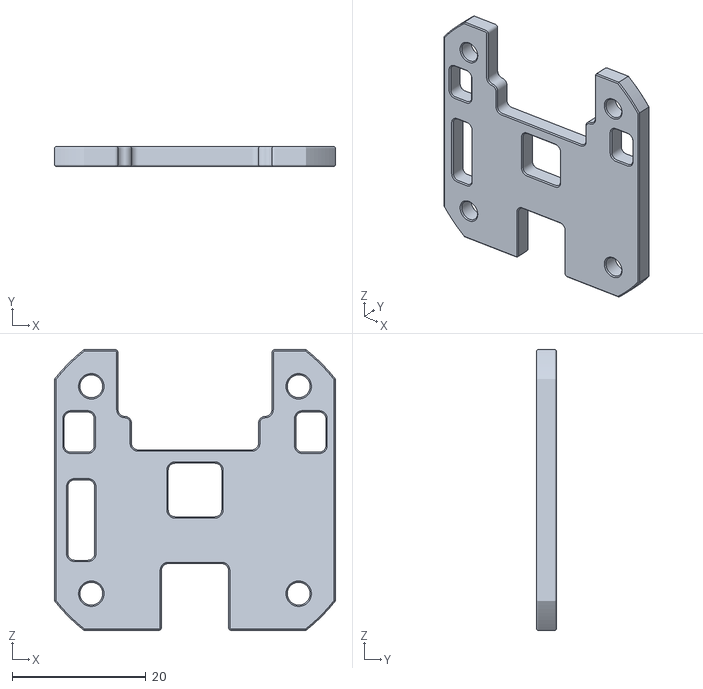
[picture p40: CAD file, 2026-04-15]
2.Model/3D打印STL文件/42PCB外壳A.stl
42.0 x 3.00 x 42.0
