Machao615/Dummy-Mar/2.Model/CNC加工STEP文件/J5法兰盘.step

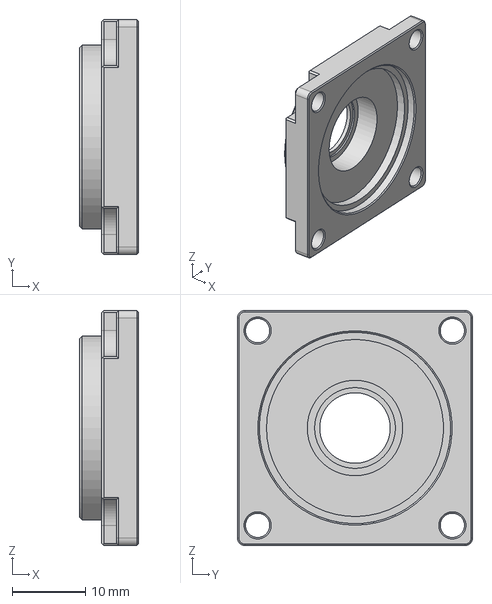
[picture p41: CAD file, 2026-04-15]
2.Model/CNC加工STEP文件/J5法兰盘.step
8.00 x 32.0 x 32.0 mm
