Machao615/Dummy-Mar/2.Model/3D打印STL文件/35PCB外壳A.3mf

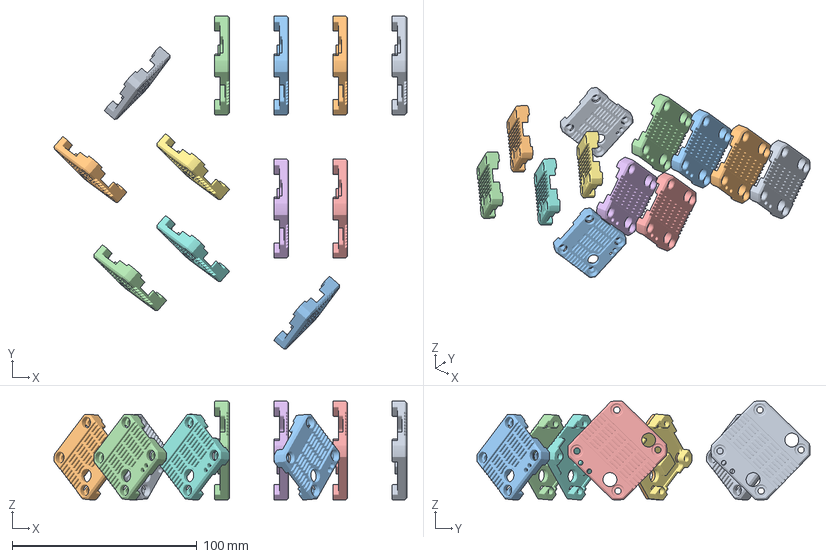
[picture p42: CAD file, 2026-04-15]
2.Model/3D打印STL文件/35PCB外壳A.3mf
190.9 x 180.2 x 53.5 mm
42PCB外壳B.stl x 6
35PCB外壳B.stl x 6
