Machao615/Dummy-Mar/2.Model/CNC加工STEP文件/J5B.step

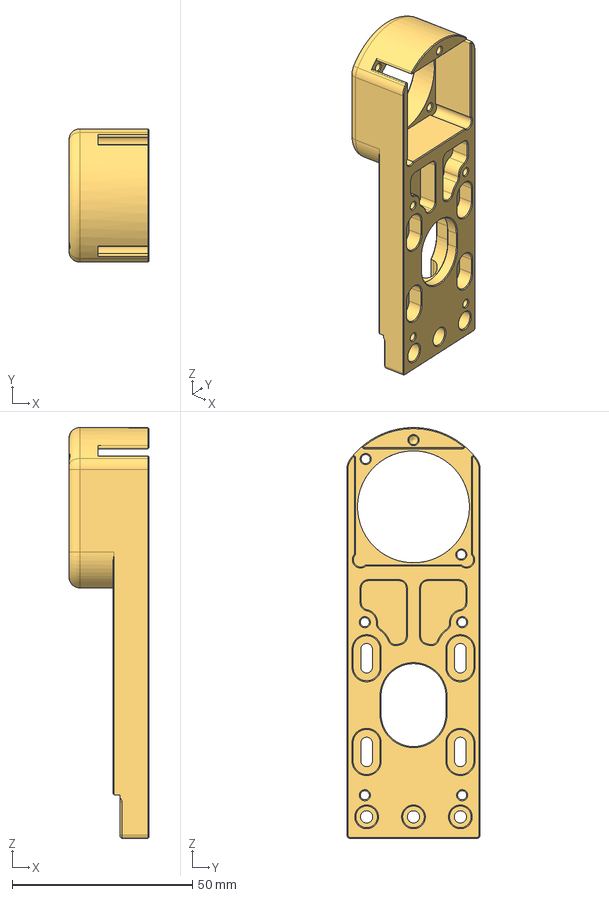
[picture p43: CAD file, 2026-04-15]
2.Model/CNC加工STEP文件/J5B.step
22.2 x 37.0 x 114.0 mm
