Machao615/Dummy-Mar/2.Model/3D打印STL文件/J5A.stl

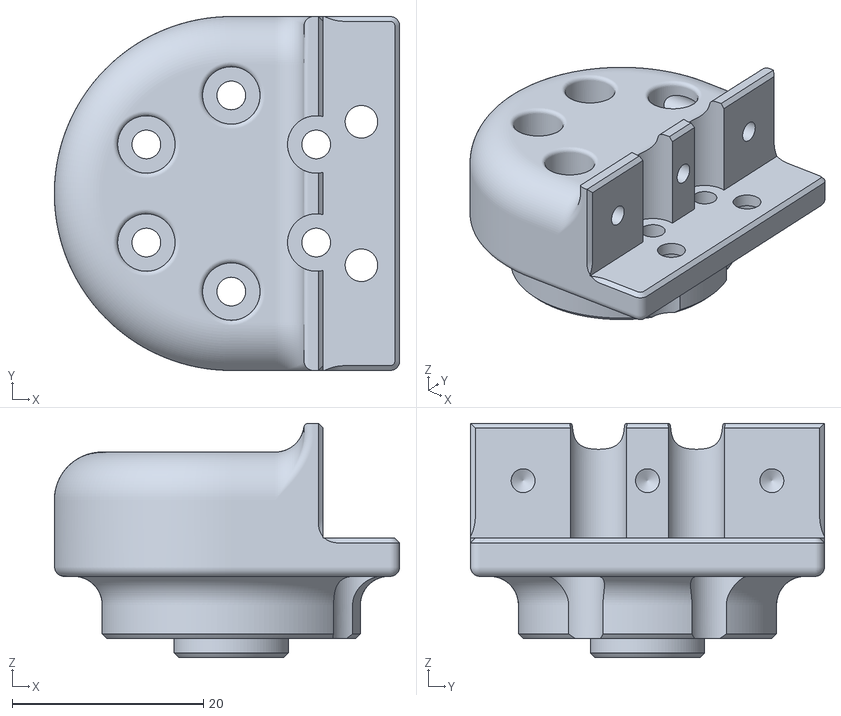
[picture p44: CAD file, 2026-04-15]
2.Model/3D打印STL文件/J5A.stl
36.1 x 37.0 x 24.5
