Machao615/Dummy-Mar/2.Model/3D打印STL文件/外壳A.stl

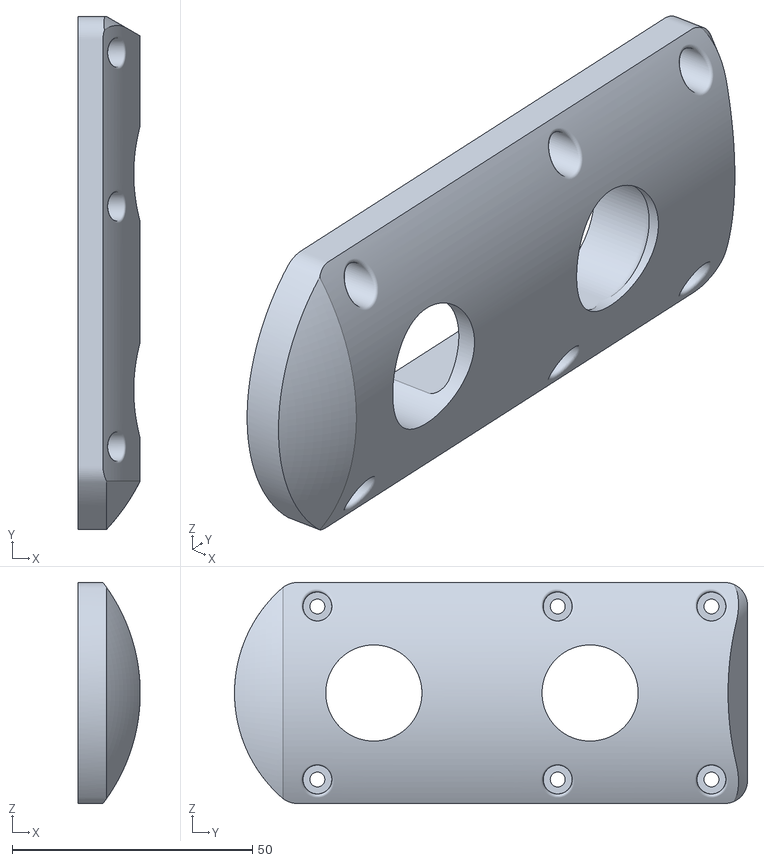
[picture p45: CAD file, 2026-04-15]
2.Model/3D打印STL文件/外壳A.stl
13.0 x 106.8 x 46.0
