Machao615/Dummy-Mar/2.Model/CNC加工STEP文件/基座.step

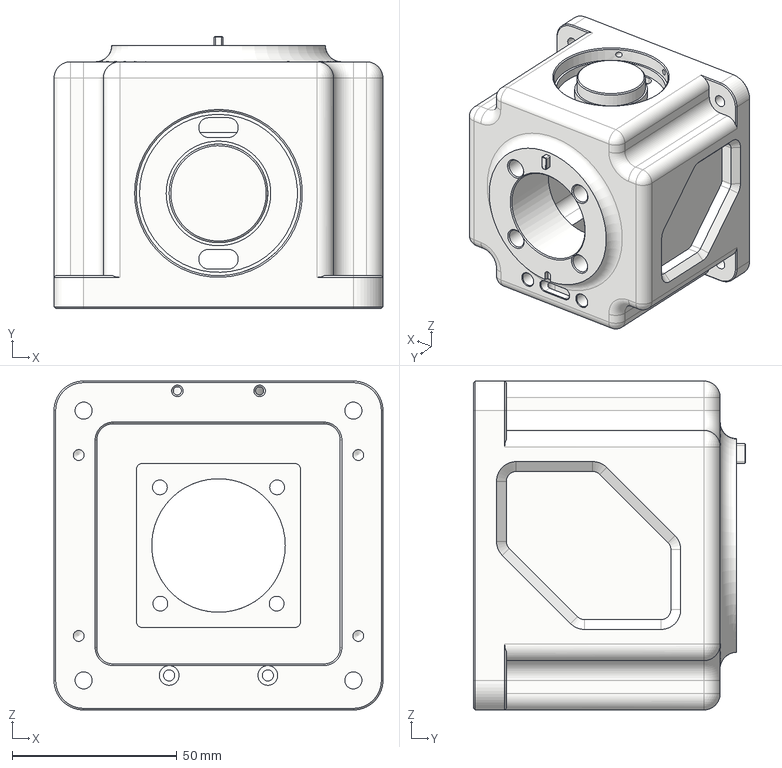
[picture p46: CAD file, 2026-04-15]
2.Model/CNC加工STEP文件/基座.step
100.0 x 82.7 x 100.0 mm
