Machao615/Dummy-Mar/2.Model/3D打印STL文件/控制器内衬.stl

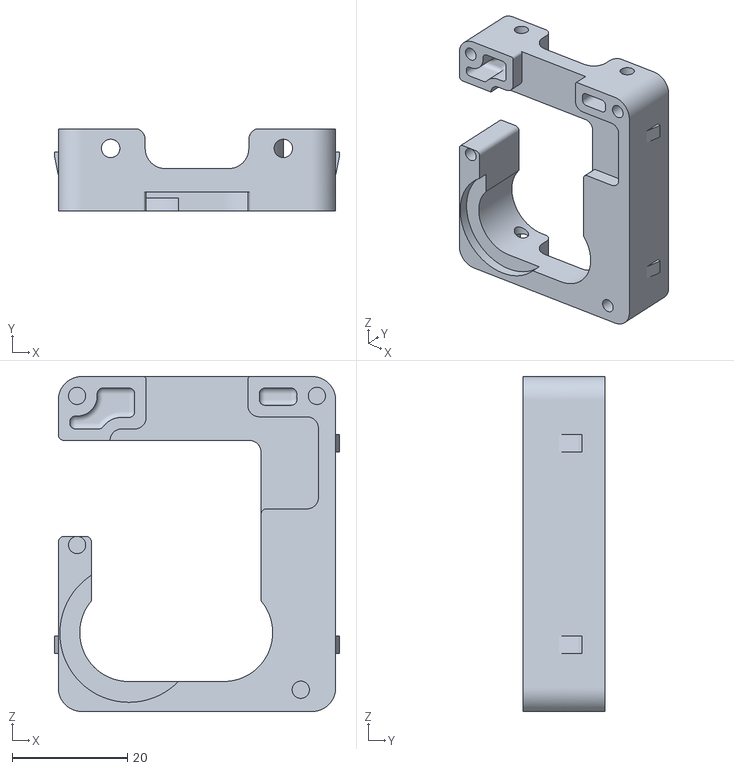
[picture p47: CAD file, 2026-04-15]
2.Model/3D打印STL文件/控制器内衬.stl
49.6 x 14.3 x 58.2
