Machao615/Dummy-Mar/2.Model/3D打印STL文件/35PCB外壳B.3mf

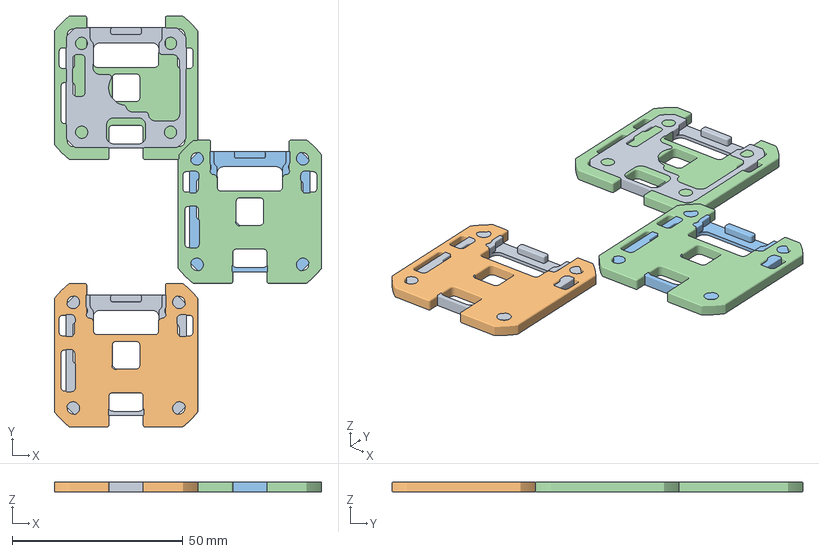
[picture p48: CAD file, 2026-04-15]
2.Model/3D打印STL文件/35PCB外壳B.3mf
78.2 x 120.2 x 3.00 mm
35PCB外壳A.stl x 6
42PCB外壳A.stl x 6
