Machao615/Dummy-Mar/2.Model/3D打印STL文件/控制器外壳.stl

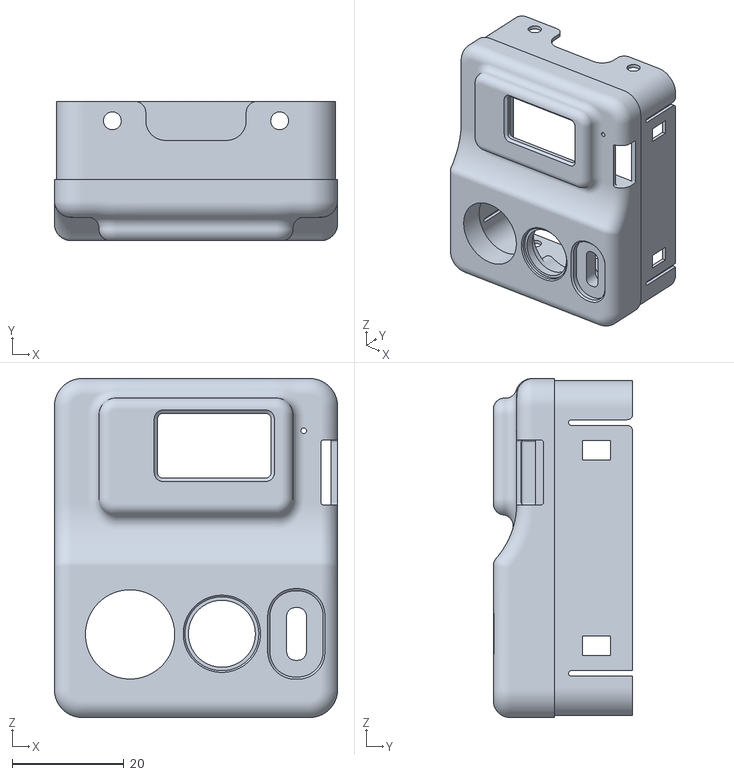
[picture p49: CAD file, 2026-04-15]
2.Model/3D打印STL文件/控制器外壳.stl
50.8 x 25.0 x 60.8
