Machao615/Dummy-Mar/2.Model/3D打印STL文件/控制器屏幕底板.stl

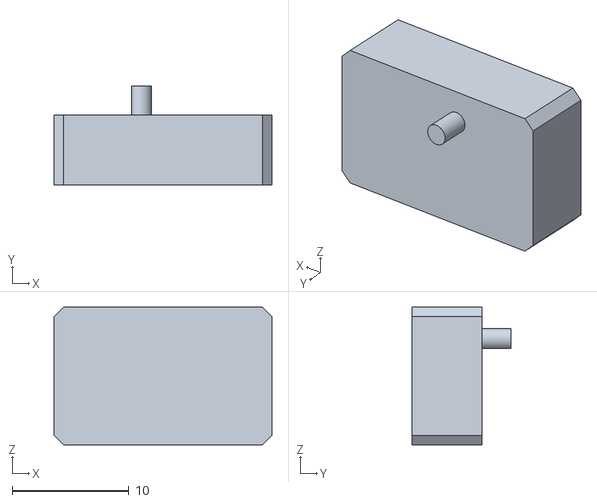
[picture p50: CAD file, 2026-04-15]
2.Model/3D打印STL文件/控制器屏幕底板.stl
18.7 x 8.50 x 11.8
