Machao615/Dummy-Mar/(list of files, cad)

Other CAD files:
2.Model/CNC加工STEP文件/J4.step
2.Model/3D打印STL文件/J2J3.stl
2.Model/CNC加工STEP文件/J1.step
2.Model/CNC加工STEP文件/J5A.step
2.Model/3D打印STL文件/J5B.stl
2.Model/3D打印STL文件/J4法兰盘.stl
2.Model/3D打印STL文件/J5法兰盘.stl
2.Model/3D打印STL文件/J1.stl
2.Model/3D打印STL文件/基座.3mf
2.Model/3D打印STL文件/J6.stl
2.Model/3D打印STL文件/35PCB外壳A.stl
2.Model/3D打印STL文件/35PCB外壳B.stl
2.Model/3D打印STL文件/基座.stl
2.Model/3D打印STL文件/基座底板.stl
