Machao615/Dummy-Mar/(list of files, drawings)

Other design files:
1.Hardware/LedRing/LedRing.PcbDoc
1.Hardware/LedRing/LedRing.PrjPCB
1.Hardware/LedRing/Main.SchDoc
1.Hardware/motor35/PCB源文件/Drive.SchDoc
1.Hardware/motor35/PCB源文件/Interface.SchDoc
1.Hardware/motor35/PCB源文件/MCU.SchDoc
1.Hardware/motor35/PCB源文件/Motor-35.PcbDoc
1.Hardware/motor35/PCB源文件/Port.SchDoc
1.Hardware/motor35/PCB源文件/Power.SchDoc
1.Hardware/motor42/PCB源文件/Drive.SchDoc
1.Hardware/motor42/PCB源文件/Interface.SchDoc
1.Hardware/motor42/PCB源文件/MCU.SchDoc
1.Hardware/motor42/PCB源文件/Motor-42.PcbDoc
1.Hardware/motor42/PCB源文件/Port.SchDoc
1.Hardware/motor42/PCB源文件/Power.SchDoc
1.Hardware/ref-controller/PCB源文件/REF-Controller.SchDoc
